leonardosilva-leic/ProjetoLIC-ISEL/Relatorios/finalReportTicketMachine.pdf

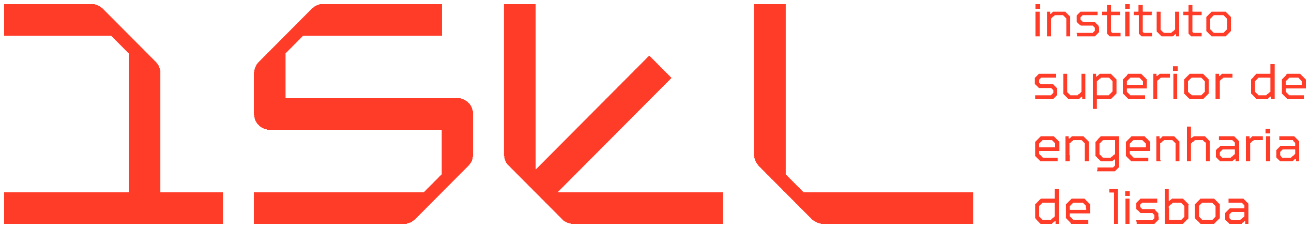
[picture p1: figure]

## Licenciatura em Engenharia Informática e de Computadores

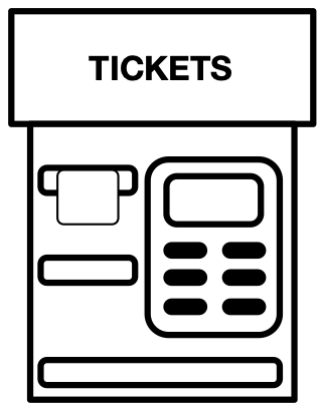
[picture p2: figure]

## MÁQUINA DE VENDA DE BILHETES

# (Ticket Machine)

Projeto
de
Laboratório de Informática e Computadores 2025 / 2026 verão

Trabalho Realizado por:
54035: Beatriz Leme 53799: Leonardo Silva 53652: Miguel Ruivo

Docentes: David Velez, Nuno Sebastião, Pedro Miguens, Rogério Rebelo, Rui

Duarte

12 de junho de 2026

2

## Conteúdo

1 Descrição | 1
2 Arquitetura do Sistema | 3
3 Resultados Experimentais | 18
4 Conclusões | 21
5 Trabalho Futuro | 21
Referências | 23
A Ticket Machine - Hardware | 24

i

B Ticket Machine - Software (Control) | 27

ii

## Lista de Figuras

1 | Diagrama de blocos da Máquina de Venda de Bilhetes (Ticket Machine) | | 1
2 | Arquitetura do sistema que implementa a máquina de venda de bilhetes (Ticket
Machine) | | 3
3 | Diagrama de blocos do Keyboard Reader | | 4
4 | Diagrama de blocos | | 4
5 | Bloco Key Decode - Diagrama temporal | | 5
6 | Diagrama temporal | | 6
7 | Diagrama de blocos | | 7
8 | Diagrama de blocos | | 8
9 | Diagrama de blocos | | 10
10 | Composição do Datapath | | 11
11 | Bloco Coin Acceptor | | 11
a | Diagrama de blocos | | 11
b | Diagrama temporal | | 11
12 | Diagrama de blocos do módulo Port Expander LCD (PELCD) | | 12
13 | Protocolo de comunicação com o módulo Port Expander LCD (PELCD) | | 12
14 | Diagrama de blocos do módulo Port Expander Ticket Dispenser (PETD) . . . . | 13
15 | Protocolo de comunicação com o Port Expander Ticket Dispenser (PETD) . . . | 13
16 | Protocolo de comunicação com o mecanismo de dispensa de bilhetes (Ticket Dis-
penser ) | | 14
17 | Diagrama de blocos do bloco Serial Receiver | | 14
18 | Diagrama lógico da Máquina de Venda de Bilhetes (Ticket Machine) | | 15
19 | Simulação do preenchimento da memória RAM do Ring Buffer e ativação dos
sinais empty e full | | 18
20 | Ativação e apresentação do menu do modo de Manutenção no simulador de hardware. 20

## Lista de Tabelas

1 | Codificação do valor facial das moedas | | 12
2 | Atribuição de pinos para a função F [4] | | 26

## Lista de Algoritmos

1 | TicketMachineAPP | | 27
2 | M | | 35
3 | TUI | | 36
4 | Coin Acceptor | | 40
5 | Coin Deposit | | 41
6 | File Access | | 42

iii

Laboratório de Informática e Computadores 2025/2026 verão Máquina de Venda de Bilhetes (Ticket Machine)

## 1 Descrição

Este projeto implementa uma máquina de venda de bilhetes (Ticket Machine), que permite a aquisição de bilhetes de comboio. O percurso é definido pela estação de origem, local de compra do bilhete e pela seleção do destino digitando o identificador da estação ou através das teclas ↑ e ↓, sendo exibido no ecrã além do identificador da estação de destino o preço e o tipo de bilhete (ida ou ida/volta). A ordem de aquisição é dada através da pressão da tecla de confirmação, sendo impressa uma unidade do bilhete exibido no ecrã. A máquina não realiza trocos e só aceita moedas de: 0,05e; 0,10e; 0,20e; 0,50e; 1,00e; e 2,00e. Para além do modo de Dispensa, o

sistema tem mais um modo de funcionamento designado por Manutenção, que é ativado por uma chave de manutenção. Este modo permite o teste da máquina de venda de bilhetes, bem como permite iniciar e consultar os contadores de bilhetes e moedas. A máquina de venda de bilhetes é constituída pelo sistema de gestão (designado por Control na Figura 1) e pelos seguintes periféricos: um teclado de 16 teclas, um moedeiro (designado por Coin Acceptor ), um ecrã Liquid Cristal Display (LCD) de duas linhas de 16 caracteres, um mecanismo de dispensa de bilhetes (designado por Ticket Dispenser ) e uma chave de manutenção (designada por M ) que define se a máquina de venda de bilhetes está em modo de Manutenção, conforme o diagrama de blocos apresentado na Figura 1.

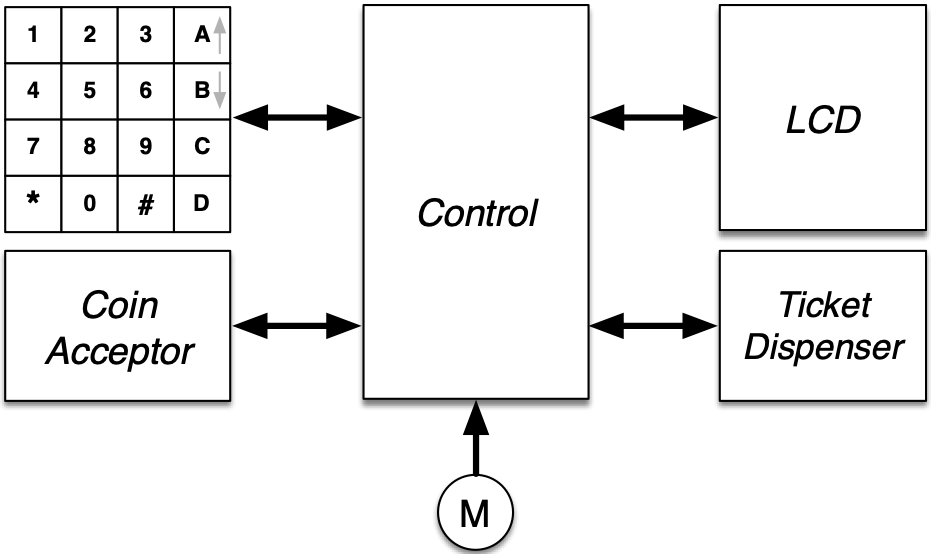
[picture p3: figure]

Figura 1: Diagrama de blocos da Máquina de Venda de Bilhetes (Ticket Machine)

Sobre o sistema podem-se realizar as seguintes ações em modo Venda:

- Consulta e venda A consulta de um bilhete é realizada digitando o identificador da estação de destino ou listando-a através das teclas ↑ e ↓. O processo de compra do bilhete inicia-se premindo a tecla ‘#’. Durante a inserção do respetivo valor monetário, é possível alterar o tipo de bilhete (ida ou ida/volta) premindo a tecla ‘∗’, com a consequente alteração do preço da viagem afixado no LCD, duplicando o valor no caso de ida/volta. Durante a compra ficam afixados no LCD as informações referentes ao bilhete pretendido até que o mecanismo de impressão de bilhetes confirme que a impressão já foi realizada e a recolha do bilhete efetuada. A compra pode ser cancelada premindo a tecla ‘#’, devolvendo as moedas inseridas.

1

Sobre o sistema podem-se realizar as seguintes ações em modo Manutenção:

- Teste – Esta opção do menu permite realizar um procedimento de consulta e venda de um bilhete, sem introdução de moedas e sem esta operação ser contabilizada como uma aquisição.
- Consulta Bilhetes – Premindo a tecla ’A’, em seguida através das teclas ↑ e ↓, visualizam os contadores do número de bilhetes vendidos.
- Consulta Moedas – Premindo a tecla ’B’, em seguida através das teclas ↑ e ↓, visualizam os contadores das moedas no cofre.
- Iniciar os contadores de moedas e bilhetes – Premindo a tecla ’C’ e em seguida a tecla ’∗’, o sistema de gestão coloca os contadores de moedas e bilhetes a zero, iniciando um novo ciclo de contagem.
- Desligar – Premindo a tecla ’D’ permite desligar o sistema, que encerra apenas após a confirmação do utilizador, ou seja, o programa termina e as estruturas de dados, contendo a informação dos contadores de moedas e da lista de bilhetes vendidos, são armazenadas de forma persistente em dois ficheiros de texto. A informação em cada ficheiros deve estar organizada por linha, em que os campos de dados são separados por “;”, com o respetivo formato: ’COIN_V ALUE; NUMBER_COINS’ (valor facial; número de moedas) e ’P RICE; SOLD_T ICKET S; ST AT ION_NAME’ (preço; número de bilhetes vendidos para a estação; nome da estação). Os dois ficheiros devem ser carregados para o sistema no seu processo de arranque.

Nota: A inserção de informação através do teclado tem o seguinte critério: i) se não for premida nenhuma tecla num intervalo de cinco segundos o comando em curso é abortado; ii) quando o dado a introduzir é composto por mais que um dígito, são considerados apenas os últimos dígitos, a inserção realiza-se do dígito de maior peso para o de menor peso.

2

## 2 Arquitetura do Sistema

O sistema implementa uma solução híbrida de hardware e software, como apresentado no diagrama de blocos da Figura 2. A arquitetura proposta é constituída por cinco módulos principais:
i) um leitor de teclado, designado por Keyboard Reader ; ii) um módulo de interface com o LCD, designado por Port Expander LCD (PELCD); iii) um módulo de interface com o mecanismo de dispensa de bilhetes (Ticket Dispenser ), designado por Port Expander Ticket Dispenser (PETD); iv) um moedeiro, designado por Coin Acceptor ; e v) um módulo de controlo, designado por Control.
Os módulos i), ii) e iii) deverão ser implementados em hardware, o moedeiro (iv) será emu-lado utilizando quatro interruptores e três LED, enquanto o módulo de controlo (v) deverá ser implementado em software, descrito em linguagem Kotlin e executado num PC.

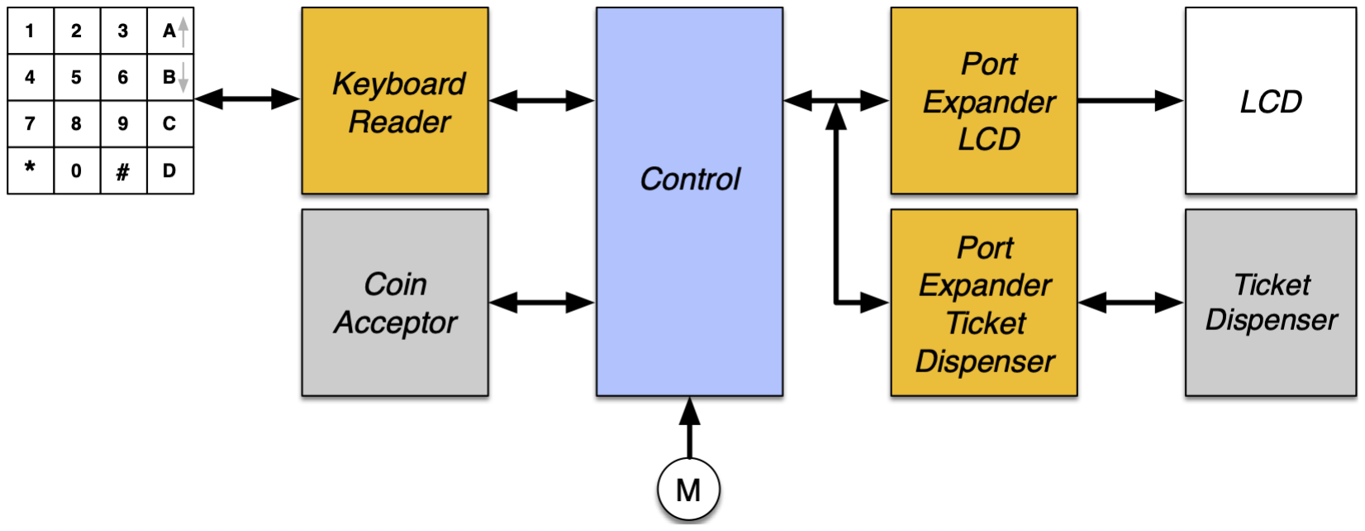
[picture p4: figure]

Figura 2: Arquitetura do sistema que implementa a máquina de venda de bilhetes (Ticket Machine)

O módulo Keyboard Reader é responsável pela descodificação do teclado matricial de 16 teclas, determinando qual a tecla pressionada e disponibilizando o seu código, com quatro bits, ao módulo Control. Caso este não esteja disponível para o receber imediatamente, o código da tecla é armazenado internamente, até ao limite de dezoito (18) códigos. O módulo Control processa os dados e envia a informação a apresentar no LCD através do módulo PELCD. O Ticket Dispenser é atuado pelo módulo Control, através do módulo PETD. Por forma a minimizar o número de interligações, a comunicação entre o módulo Control e os módulos PELCD e PETD é realizada através de um protocolo série.

### 2.1 Keyboard Reader

O módulo Keyboard Reader [1] é constituído por três blocos principais: i) o descodificador de teclado (Key Decode); ii) o bloco de armazenamento (designado por Ring Buffer ); e iii) o bloco de entrega ao consumidor (designado por Key Transmitter ). Neste caso o módulo Control, implementado em software, é a entidade consumidora.

3

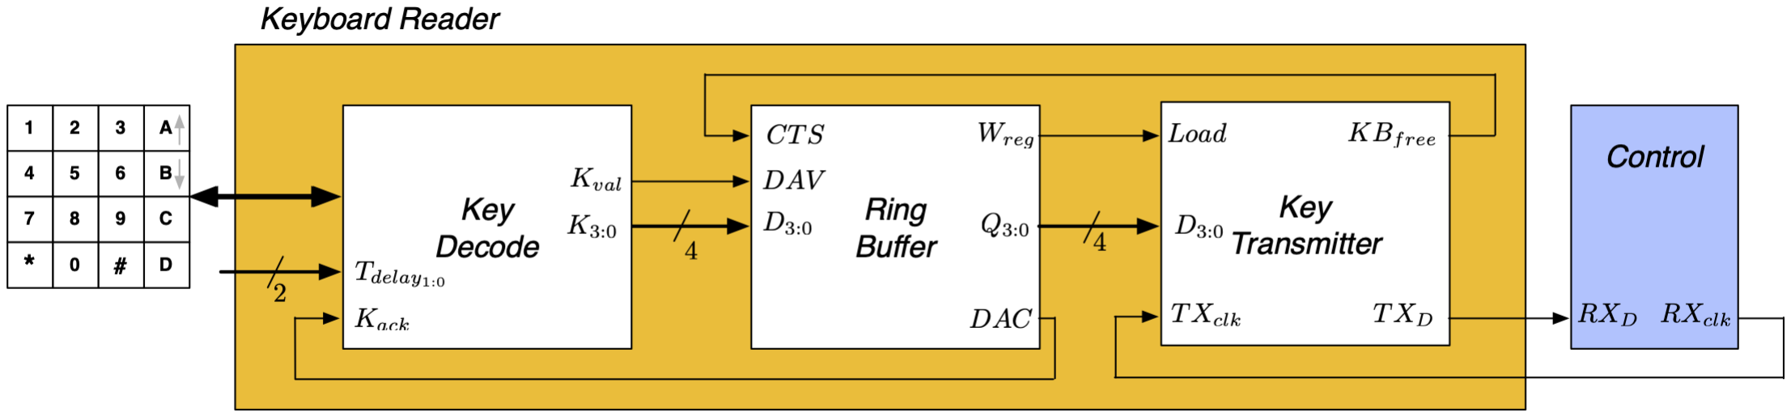
[picture p5: figure]

Figura 3: Diagrama de blocos do Keyboard Reader

### 2.1.1 KeyDecode

O bloco Key Decode tem como principal função implementar um descodificador em hardware para um teclado matricial de 4 × 4. Estruturalmente, este sistema divide-se em três sub-blocos essenciais:

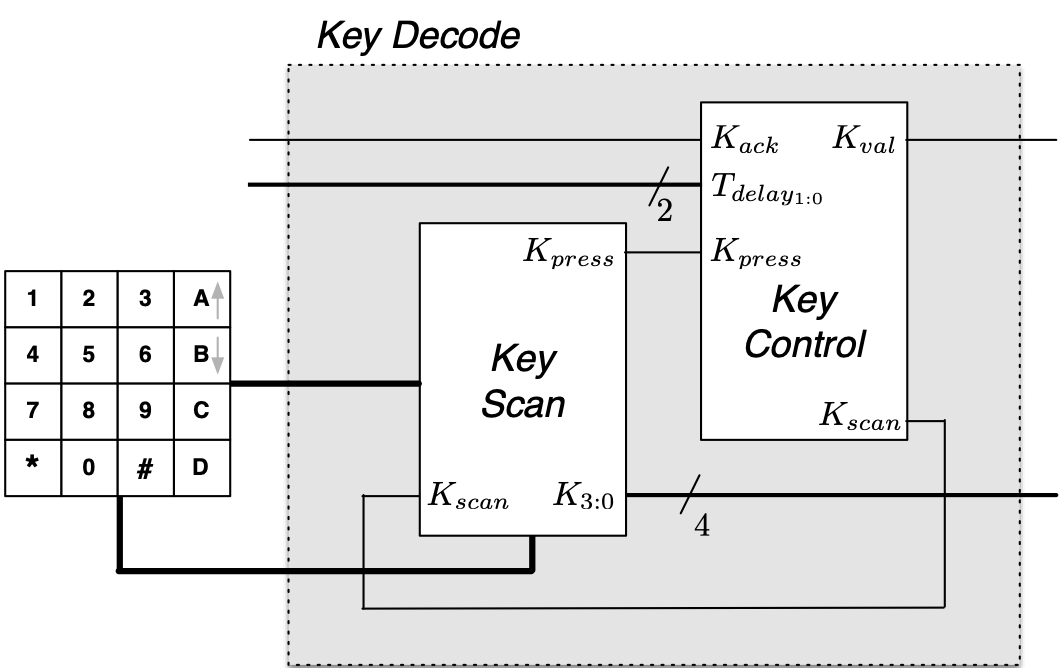
[picture p6: figure]

Figura 4: Diagrama de blocos

Teclado matricial: A interface física de 4 × 4.

Key Scan: O módulo responsável por efetuar o varrimento contínuo das teclas, percorrendo as colunas á procura de uma linha que tenha sido ativada ao premir o botão do teclado.

Key Control: A unidade lógica que realiza o controlo do varrimento e gere o fluxo de dados do sistema que controla o Tdelay e segue o ASM presente na Figura 5.

4

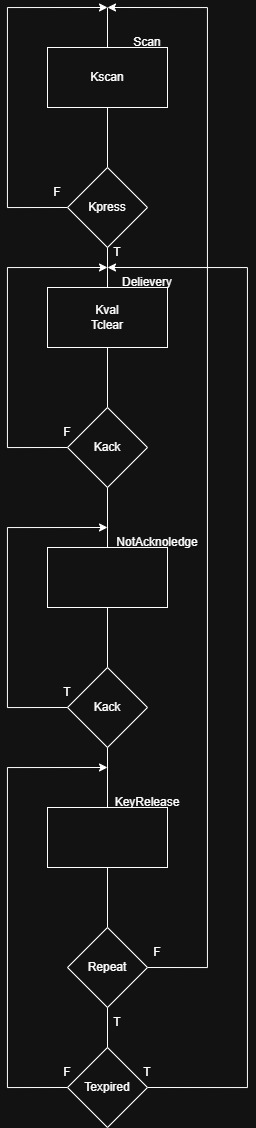
[picture p7: figure]

Figura 5: Bloco Key Decode - Diagrama temporal

5

Sempre que o sistema deteta a pressão de uma tecla, o sinal de saída Kval é ativado. Simultane-amente, o código representativo dessa tecla é disponibilizado no barramento de dados K3:0.

Numa fase inicial, um novo ciclo de varrimento apenas se inicia após a tecla ser libertada e mediante a receção do sinal de reconhecimento Kack.

Numa segunda fase do projeto, o sistema incorpora um mecanismo de repetição de tecla (auto repeat). Caso a tecla se mantenha pressionada, o sistema gera automaticamente um novo código após um período de tempo pré-determinado, definido pela variável de entrada Tdelay1:0 . Os períodos de atraso configuráveis são os seguintes:

- 00: 500 ms
- 01: 1000 ms
- 10: 1500 ms
- 11: 2000 ms

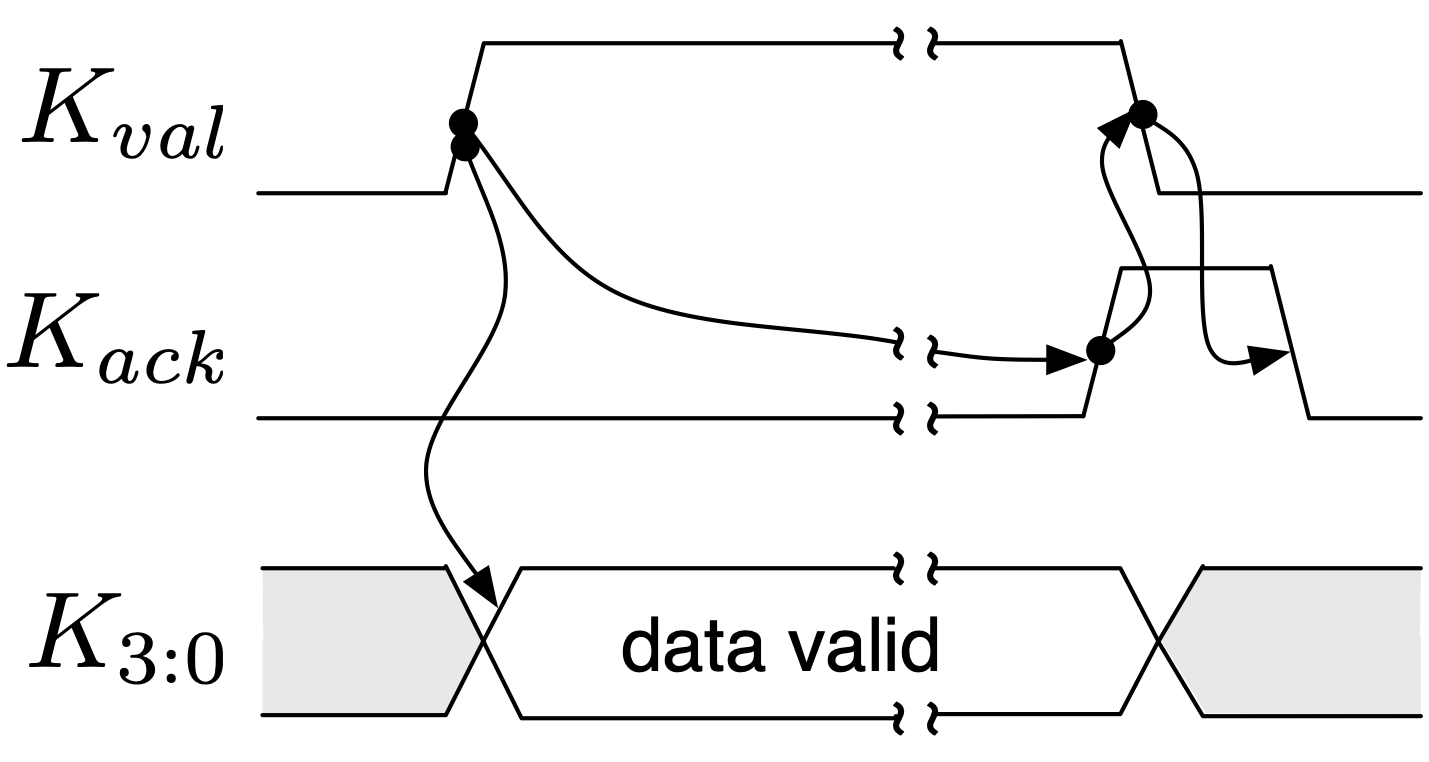
[picture p8: figure]

Figura 6: Diagrama temporal

Para a realização do varrimento do teclado, foi adotada a Versão I da arquitetura do bloco Key Scan.Nesta configuração, o circuito é conduzido por um oscilador que alimenta o sinal de clock de um contador síncrono. As saídas deste contador são divididas para controlar dois componentes em paralelo:

6

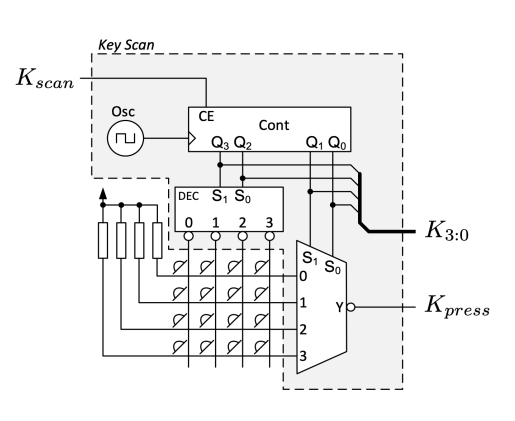
[picture p9: figure]

Figura 7: Diagrama de blocos

Descodificador (Decoder): Recebe parte dos bits do contador para ativar sequencialmente as linhas do teclado matricial.

Multiplexer (MUX): Utiliza os restantes bits do contador como sinais de seleção para ler o estado das colunas do teclado, canalizando o resultado para a saída Kpress.

Esta abordagem garante um varrimento cíclico e sincronizado, permitindo que o bloco Key Control identifique de forma precisa as coordenadas da tecla acionada.

### 2.1.2 RingBuffer

O bloco Ring Buffer implementa uma estrutura de dados para armazenamento de teclas com disciplina FIFO, com capacidade de armazenar até dezasseis (16) palavras de quatro (4) bits. E é composto por 3 sub-blocos: O Memory Adress Control (MAC) que tem como objetivo indicar o endereço respetivo à operação realizada de acordo com a entrada de seleção PnG do bloco, o RingBufferControl que é a maquina de estados que vai controlara o RingBuffer tendo em conta os sinais que vai receber provenientes do KeyDecode (DAV) e do KeyTransmitter(CTS) e por fim a RAM que vai armazenar as 16 palavaras de 4 bits.

7

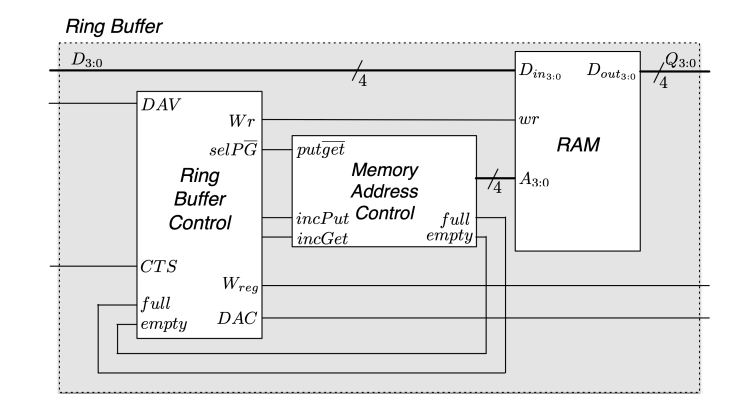
[picture p10: figure]

Figura 8: Diagrama de blocos

### 2.1.3 RingBufferControl

A coordenação do fluxo de dados e da interação com os módulos adjacentes é realizada pelo bloco Ring Buffer Control, cujo comportamento é ditado pela máquina de estados implementada. A partir do seu estado inicial (Idle), o sistema ramifica a sua execução consoante se trate de um processo de escrita ou de leitura:
1. Processo de Escrita (Interação com o Sistema Produtor):
- A escrita é desencadeada quando o sistema produtor (neste caso, o Key Decode) ativa o sinal DAV (Data Available).
- Se a memória não estiver cheia (condição Full falsa), a máquina transita para o estado prev_Write, ativando o sinal PnG para selecionar o endereço putIndex no MAC.
- No estado seguinte, Writing, o sistema ativa o sinal de escrita Wr mantendo o PnG ativo, o que efetiva o registo dos dados D3:0 na RAM.
- Imediatamente a seguir, no estado pos_write, é emitido o comando incput (em conjunto com o PnG) para atualizar o endereço de escrita.
- Concluída esta etapa, a máquina entra no estado ack_Producer, ativando o sinal DAC (Data Accepted). Esta ação serve para informar o sistema produtor de que os dados foram guardados com sucesso.
- O sistema produtor deve então desativar o DAV; só após essa desativação é que a máquina de estados abandona o estado ack_Producer, regressando a Idle e desativando consequen-temente o DAC.
2. Processo de Leitura (Interação com a Entidade Consumidora):
- A leitura de dados ocorre sempre que a entidade consumidora indica disponibilidade para receber informação, através da ativação do sinal CTS (Clear To Send).
- A partir do estado Idle, caso não haja solicitações pendentes de escrita (ou se houver uma solicitação de escrita mas a RAM estiver cheia), a máquina verifica o estado do sinal CTS.

8

- Se o CTS estiver ativo e houver dados disponíveis na memória (condição Empty falsa), a máquina avança para o estado Reading. Neste estado, é gerado o sinal Wreg.
- O sistema aguarda no estado Reading até que o sinal CTS seja desativado pela entidade consumidora.
- Após a transição descendente de CTS, a máquina passa para o estado pos_Read, onde emite o sinal incget para incrementar o endereço de leitura no MAC. Finalmente, retorna ao estado Idle, concluindo o ciclo.

9

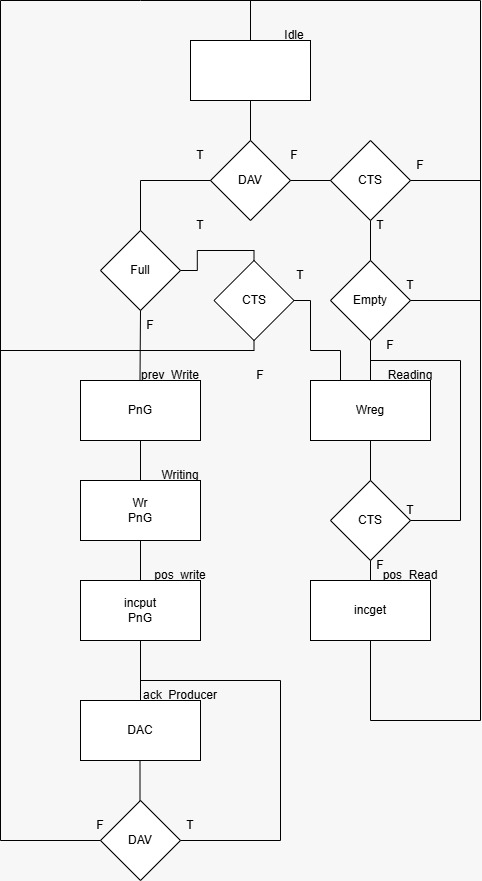
[picture p11: figure]

Figura 9: Diagrama de blocos

### 2.1.4 KeyTransmiter

O bloco Key Transmitter é responsavel por atuar como uma interface de comunicação série entre o módulo produtor (responsável por registar fisicamente a tecla pressionada) e o módulo consumidor (o módulo Control central do sistema). O mesmo é composto por 2 sub-blocos

10 muito importantes: o Datapath que contem os componentes físicos necessários para armazenar e encaminhar os bits corretos para a saída série(a sua composição está presente na Figura 10) e o Controlo que é o que vai controlar o Datapath seguindo o ASM presente na Figura 10.

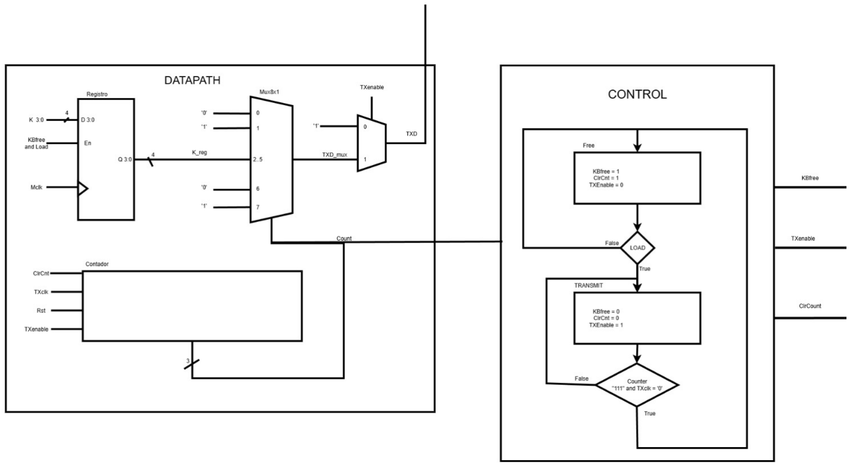
[picture p12: figure]

Figura 10: Composição do Datapath

### 2.2 Coin Acceptor

O módulo Coin Acceptor implementa a interface com o moedeiro, sinalizando ao módulo Control que o moedeiro recebeu uma moeda através da ativação do sinal Coin, o valor monetário da moeda inserida é codificado em Coinid2:0 , conforme a codificação apresentada na Tabela 1. A entidade consumidora informa o Coin Acceptor que já contabilizou a moeda ativando o sinal accept, conforme apresentado no diagrama temporal da Figura 11b. O Control pode devolver as moedas inseridas no moedeiro através da ativação do sinal eject durante dois segundos, ou reco-lher as moedas presentes no moedeiro através da ativação do sinal collect durante dois segundos.

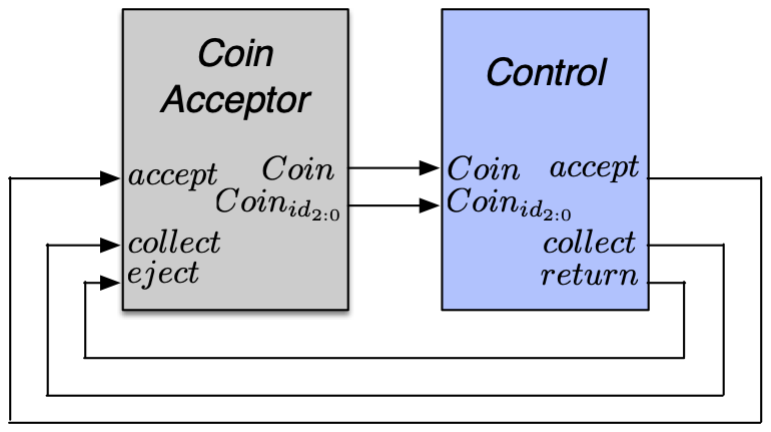
[picture p13: figure]

(a) Diagrama de blocos | (b) Diagrama temporal

Figura 11: Bloco Coin Acceptor

11

Tabela 1: Codificação do valor facial das moedas

Moeda [e] | Codificação [Cid2Cid1Cid0]
0,05 | 000
0,10 | 001
0,20 | 010
0,50 | 011
1,00 | 100
2,00 | 101

### 2.3 Port Expander LCD

O módulo Port Expander LCD [2] (PELCD) implementa a interface com o LCD, fazendo a receção em série da informação enviada pelo módulo de controlo e entregando-a posteriormente ao LCD, conforme representado na Figura 12.

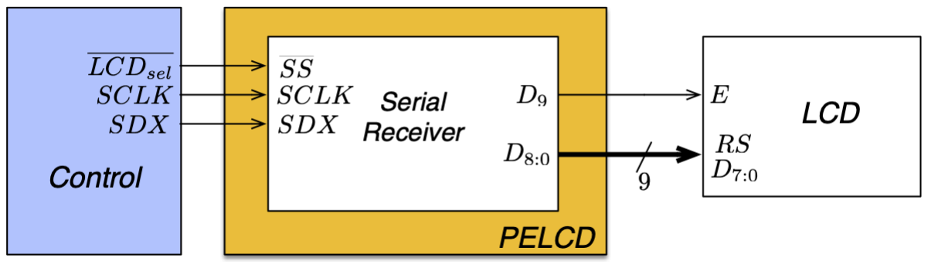
[picture p14: figure]

Figura 12: Diagrama de blocos do módulo Port Expander LCD (PELCD)

O módulo PELCD recebe em série uma mensagem constituída por dez (10) bits de informação. A comunicação com este módulo realiza-se segundo o protocolo ilustrado na Figura 13, em que o bit RS é o primeiro bit de informação e indica se a mensagem é de controlo ou dados. Os seguintes oito (8) bits contêm os dados a entregar ao LCD. O último bit contém o sinal de E responsável por registar a informação no LCD.

Figura 13: Protocolo de comunicação com o módulo Port Expander LCD (PELCD)

O emissor, realizado em software, quando pretende enviar uma trama para o módulo PELCD promove uma condição de início de trama (Start), que corresponde a uma transição descendente na linha (LCDsel). Após a condição de início, o módulo PELCD armazena os bits de dados da trama nas transições ascendentes do sinal SCLK. O bloco Serial Receiver do módulo PELCD é constituído por dois blocos principais: i) um registo de deslocamento; e ii) um registo de manutenção; designados por Shift Register e Hold Register respetivamente. O bloco Serial Receiver

12 deverá ser implementado com base no diagrama de blocos apresentado na Figura 17.

### 2.4 Port Expander Ticket Dispenser

O módulo Port Expander Ticket Dispenser [3] (PETD) implementa a interface com o mecanismo de impressão de bilhetes (Ticket Dispenser ), realizando a receção em série da informação enviada pelo módulo de controlo e entregando-a posteriormente ao mecanismo, conforme representado na Figura 14.

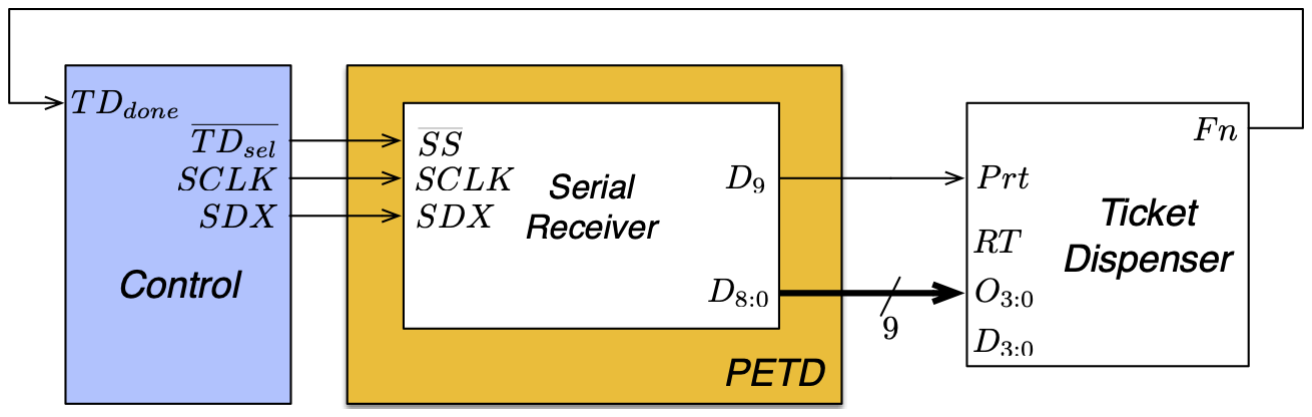
[picture p15: figure]

Figura 14: Diagrama de blocos do módulo Port Expander Ticket Dispenser (PETD)

O módulo PETD recebe em série uma mensagem composta por dez (10) bits de informação, segundo o protocolo de comunicação ilustrado na Figura 15. O primeiro bit de informação indica se o bilhete a imprimir é de ida ou ida/volta. Os quatro bits seguintes indicam a estação de origem, seguido da estação de destino por mais 4 bits de informação. O último bit de informação indica o início da impressão e disponibilização do bilhete. Só pode ser iniciada nova impressão quando o mecanismo de dispensa de bilhetes informar o Control que o processo terminou através do sinal Fn.

Figura 15: Protocolo de comunicação com o Port Expander Ticket Dispenser (PETD)

O Ticket Dispenser recebe em 4 bits o código da estação de destino (D3:0), noutros 4 bits o código da estação de origem (O3:0) a imprimir no bilhete e ainda o bit RT que define o tipo de bilhete (ida ou ida/volta). O comando de impressão do bilhete com os códigos presentes em D, O e RT é realizado pela ativação do sinal de impressão (P rt). Em resposta, o Ticket Dispenser ativa o sinal de término de execução (F n) quando concluída a dispensa do bilhete. Os sinais F n e P rt têm o comportamento descrito no diagrama temporal apresentado na Figura 16.

13

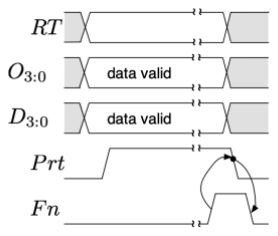
[picture p16: figure]

Figura 16: Protocolo de comunicação com o mecanismo de dispensa de bilhetes (Ticket Dispenser )

### 2.4.1 SeriaReciver

Tanto o Port Expander LCD como Port Expander Ticket Dispenser utilizam o componete SerialReciver que é responsável por interpretar as tramas enviadas pelo sistema de controlo através de uma linha série.

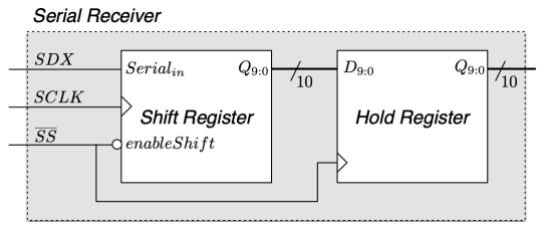
[picture p17: figure]

Figura 17: Diagrama de blocos do bloco Serial Receiver

### 2.5 Control

A implementação do módulo Control foi realizada em software, usando a linguagem Kotlin e seguindo a arquitetura lógica apresentada na Figura 18. O Controlo contem:

### 2.5.1 HAL

O HLA é o responavel por isolar a lógica aplicacional dos detalhes físicos do sistema, fornecendo uma interface simplificada para a manipulação dos portos de entrada e saída através do módulo UsbPort.

14

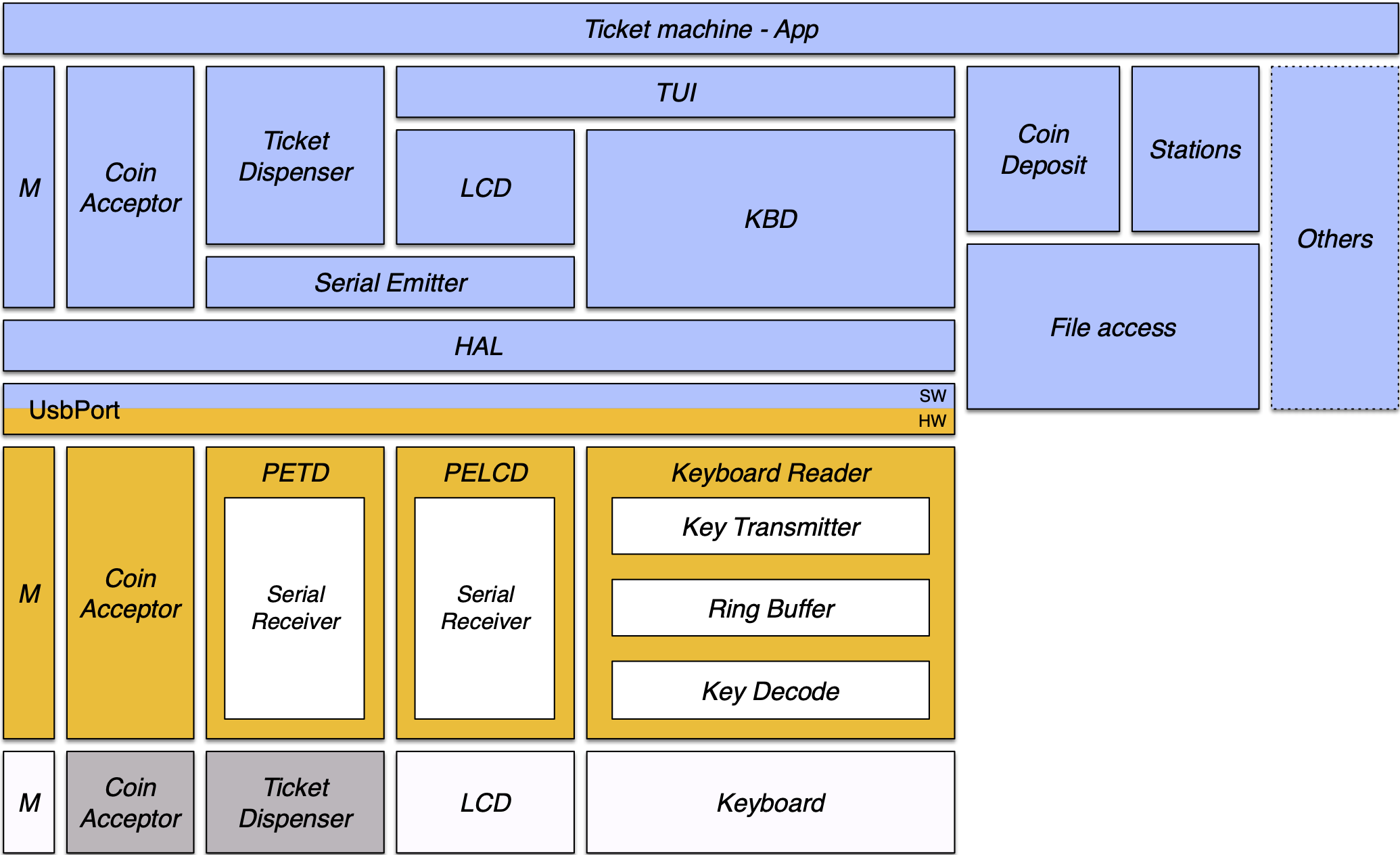
[picture p18: figure]

Figura 18: Diagrama lógico da Máquina de Venda de Bilhetes (Ticket Machine)

### 2.5.2 KBD

O módulo KBD a gere e leitura do teclado matricial, abstendo-se dos detalhes de comunicação física ao interagir com as camadas inferiores através dos módulos HAL e SerialReceiver. Na sua inicialização, o módulo assegura a correta configuração dos periféricos e do recetor de dados em série, preparando o sistema para a captura de eventos de pressão de teclas e está tambem encarregue da tradução dos sinais logicos para os caracteres defeniudos no mesmo.

### 2.5.3 TUI

O módulo TUI é o responsável por gerir tudo o que o utilizador vê no ecrã e as teclas que prime, servindo de ponte entre o ecrã (LCD) e o teclado (KBD). Na inicialização, este módulo prepara o ecrã e o teclado, controlando os menus da aplicação.

### 2.5.4 LCD

O módulo LCD é o responsável por controlar diretamente o ecrã de 2 linhas por 16 colunas. Ele serve para traduzir o texto e os comandos que o programa envia em sinais elétricos que o ecrã consegue processar, comunicando através do módulo SerialEmitter.

### 2.5.5 TD

O módulo TD (Ticket Dispenser) é o componente encarregue de controlar o hardware responsável pela impressão e emissão física dos bilhetes. Ele traduz as escolhas feitas pelo utilizador no programa em dados binários estruturados que são enviados para a impressora periférica através do módulo SerialEmitter.

15

### 2.5.6 SerialReciver

O módulo SerialReceiver é o responsável por receber dados enviados em série pelo hardware (neste caso, os códigos das teclas do teclado) e transformá-los em valores numéricos que o programa consegue usar. Ele funciona através do controlo manual de um sinal de relógio (clock) e da leitura de uma linha de dados (RXD).

### 2.5.7 SerialEmitter

O módulo SerialEmitter traduz comandos e dados do programa para um formato em série de forma a enviá-los para os periféricos. Partilha as mesmas linhas de dados (SDX) e de relógio (SCLK) que o SerialReciver, mas consegue escolher qual o componente que vai receber a informação através de linhas de seleção dedicadas.

### 2.5.8 CoinAcceptor

O módulo CoinAcceptor é o responsável por controlar o hardware do moedeiro da máquina. Ele interage diretamente com os pinos da HAL para detetar quando o utilizador insere moedas, identificar o seu valor em cêntimos e comandar os switchs que aceitam, devolvem ou guardam o dinheiro.

### 2.5.9 CoinDeposit

O ficheiro CoinDeposit define uma estrutura de dados simples (CoinEntry), que serve para gerir o inventário e a contabilidade do dinheiro dentro do sistema. Ao contrário dos módulos ante-riores, este componente não mexe diretamente no hardware, servindo apenas para organizar a informação em memória.

### 2.5.10 FileAccess

O módulo FileAccess é o modulo encarregue de garantir a persistência de dados do sistema, permitindo guardar e carregar informações diretamente em ficheiros de texto do computador. Desta forma, a máquina não perde o histórico de bilhetes vendidos nem o stock de moedas quando é desligada.

### 2.5.11 M

O módulo M é um componente muito simples que serve exclusivamente para detetar o estado do interruptor físico de manutenção da máquina. Este interruptor é o que define se a máquina está em modo de funcionamento normal ou em modo de manutenção.

### 2.5.12 Stations

O ficheiro Stations define uma estrutura de dados simples chamada Station, que serve para guardar na memória do programa todas as informações individuais sobre cada paragem disponível na máquina. Tal como o depósito de moedas.

16

### 2.5.13 TicketMachineAPP

O módulo TicketMachineApp controla o funcionamento global da máquina de bilhetes, ligando todos os módulos criados anteriormente (moedeiro, ecrã, teclado, ficheiros e impressora) e gerindo os passos que o utilizador tem de dar para comprar um bilhete.

17

## 3 Resultados Experimentais

### 3.1 Simulação Funcional do Hardware

Para verificar o correto funcionamento dos módulos implementados em VHDL, recorreu-se ao ModelSim para executar as respetivas simulações funcionais. Foram desenvolvidas testbenches para os diferentes componentes do sistema, permitindo estimular os sinais de entrada e observar os correspondentes sinais de saída e de controlo.
Durante as simulações foram analisados, entre outros aspetos, o funcionamento das máquinas de estados, os protocolos de comunicação entre os diferentes módulos, o armazenamento e a transmissão dos dados, a ativação dos sinais de validação e confirmação e a correta receção das tramas série.
Foram realizadas simulações individuais dos módulos Key Decode, Ring Buffer, Key Transmitter, Coin Acceptor, Port Expander LCD e Port Expander Ticket Dispenser, bem como testes de integração entre os blocos que constituem o sistema.
Como exemplo dos testes realizados, apresenta-se na Figura 19 a simulação do armazenamento de dados na memória RAM utilizada pelo Ring Buffer. Este módulo implementa uma estrutura de armazenamento com disciplina FIFO (First In, First Out), com capacidade para dezasseis palavras de quatro bits.
Durante o teste foram introduzidos sequencialmente os valores compreendidos entre 0000 e 1111. Na forma de onda é possível observar que cada valor é armazenado numa posição diferente da memória, preenchendo sucessivamente as dezasseis posições disponíveis.
Inicialmente, o sinal empty encontra-se ativo, indicando que o Ring Buffer não contém dados armazenados. Após a primeira operação de escrita, este sinal é desativado. À medida que são

introduzidos novos valores, as posições seguintes da memória são preenchidas até ser atingida a capacidade máxima da estrutura.
Após a escrita do décimo sexto elemento, o sinal full é ativado, indicando que não existem posições livres para o armazenamento de novos dados. Posteriormente, quando é realizada uma operação de leitura e uma posição volta a ficar disponível, o sinal full é desativado.
A simulação permitiu, assim, confirmar a correta escrita dos dados nas posições da memória RAM e o funcionamento dos sinais de estado empty e full, responsáveis por indicar, respetivamente, se o Ring Buffer se encontra vazio ou completamente preenchido.

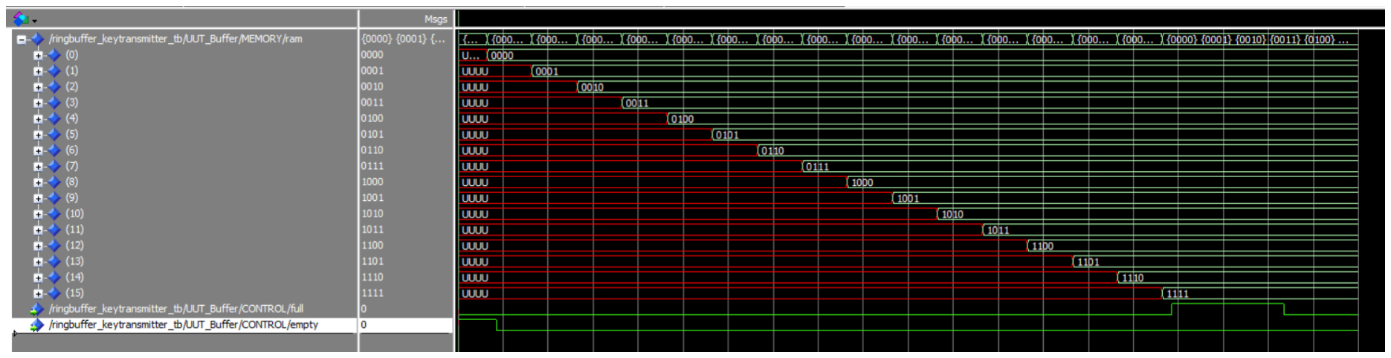
[picture p19: figure]

Figura 19: Simulação do preenchimento da memória RAM do Ring Buffer e ativação dos sinais empty e full.

18

### 3.2 Simulação do Software

Para validar o funcionamento da aplicação desenvolvida em Kotlin sem recorrer diretamente à placa FPGA, foi utilizado o simulador de hardware disponibilizado pelos docentes. Este ambiente permite emular os principais periféricos da Máquina de Venda de Bilhetes, nomeadamente o teclado matricial, o LCD, o Coin Acceptor, o Keyboard Transmitter, o Ring Buffer e o Ticket Dispenser.
A utilização do simulador permitiu testar a interação entre o módulo de controlo implementado em software e os diferentes componentes de hardware emulados. Foram verificadas as funcionalidades associadas ao modo de Venda e ao modo de Manutenção, incluindo a seleção de destinos, a aquisição e o cancelamento de bilhetes, a introdução de moedas e a consulta dos respetivos contadores.
Como exemplo dos testes realizados, apresenta-se na Figura 20 a ativação do modo de Manutenção. Este modo é selecionado através da chave de manutenção, representada pelo sinal M no simulador.
Após a ativação da chave, a aplicação abandona o funcionamento normal de venda e apre-senta no LCD o menu correspondente às operações de manutenção. Na situação representada, é apresentada a opção de consulta dos contadores de moedas, permitindo ao utilizador aceder às informações relativas às moedas armazenadas no sistema.
Através do teclado, é possível selecionar as diferentes funcionalidades do modo de Manutenção, nomeadamente o teste da máquina, a consulta dos contadores de bilhetes, a consulta dos contadores de moedas, a inicialização dos contadores e o encerramento da aplicação.
A simulação permitiu confirmar a correta deteção da chave de manutenção, a alteração do modo de funcionamento da aplicação e a apresentação das respetivas opções no LCD.

19

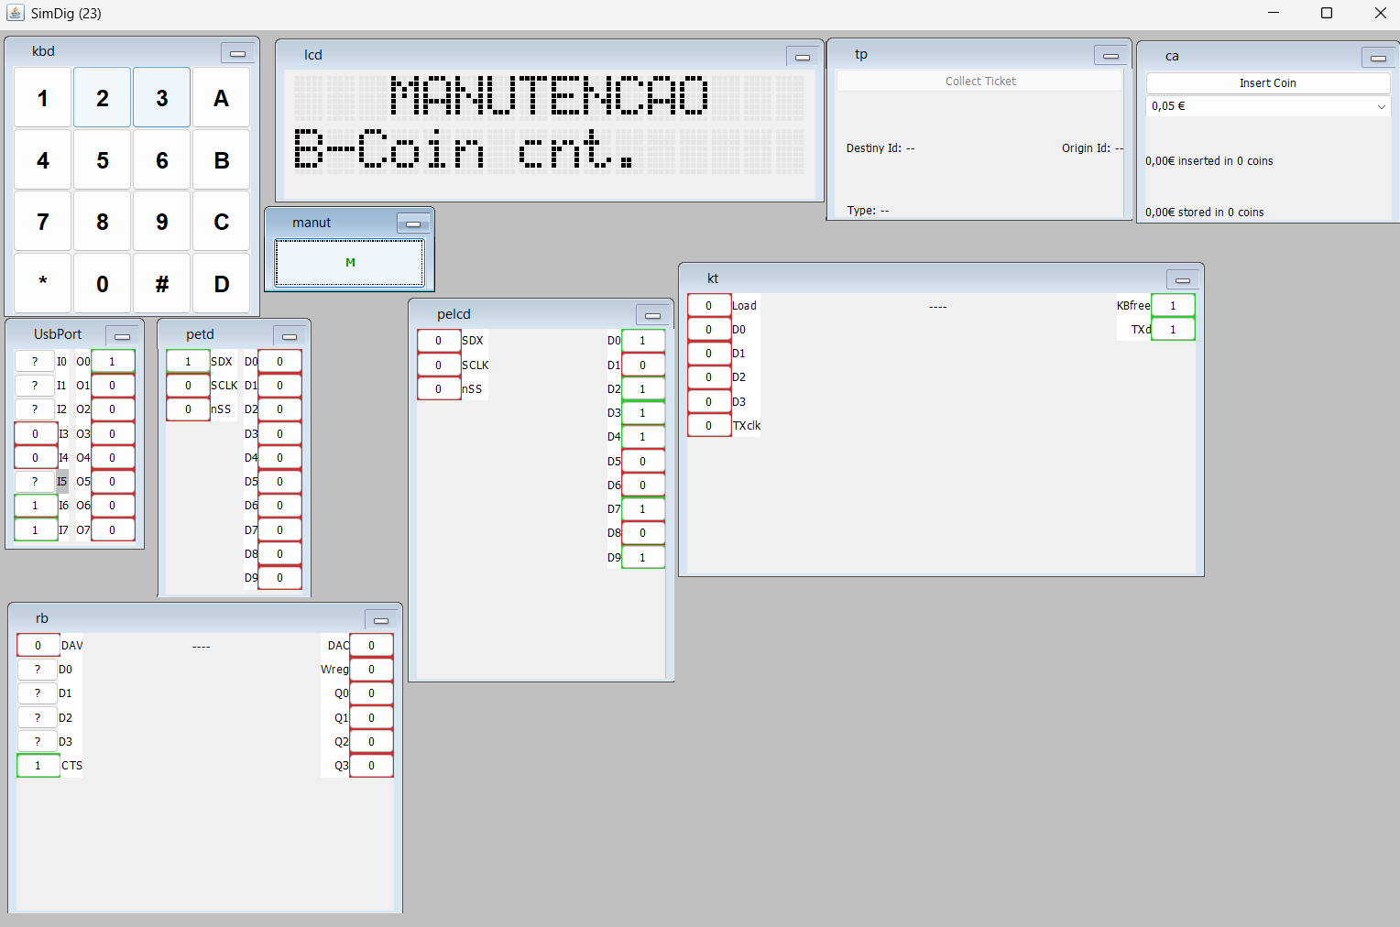
[picture p20: figure]

Figura 20: Ativação e apresentação do menu do modo de Manutenção no simulador de hardware.

20

## 4 Conclusões

O trabalho consistiu no desenvolvimento de uma máquina de venda de bilhetes chamada "Ticket Machine", conjugando componentes de hardware e software para garantir o funcionamento de todas as funções presentes na descrição do projeto. Para esse efeito, foi utilizada uma FPGA pro-gramada com a linguagem de descrição de hardware VHDL, a partir do ambiente Quartus Prime, e um computador com um software de controlo implementado em Kotlin. Os resultados experimentais confirmam o funcionamento do circuito de acordo com a descrição do funcionamento apresentada no enunciado.
Estes resultados foram obtidos a partir de testes realizados a cada componente, utilizando o ModelSim, uma extensão do programa Quartus que permite testar os componentes a partir dos ficheiros testbench que criámos, onde simulámos sinais e valores de entrada para observar os valores de saída e, assim, verificar o bom funcionamento de cada bloco que constitui o hardware do sistema.
Para realizar testes ao software em Kotlin, foi utilizado o ficheiro de simulação fornecido pelos docentes, que permite simular o software individualmente, para depois ser conectado ao hardware e testar o conjunto na placa de desenvolvimento FPGA DE10-Lite.
Os testes em hardware do sistema completo permitiram verificar o funcionamento total do sistema e também a realização de pequenos ajustes para o melhor funcionamento da máquina de venda de bilhetes implementada pelo grupo.

## 5 Trabalho Futuro

O trabalho pode ser melhorado em diversos aspetos, tanto ao nível do hardware como do software. No lado do hardware, uma possível otimização seria a remoção da estrutura de dados com disciplina FIFO (Ring Buffer) presente no módulo Keyboard Reader, uma vez que, no contexto atual do projeto, o sistema de controlo consome os dados praticamente ao mesmo ritmo a que são produzidos. Isto torna os buffers, na prática, dispensáveis, permitindo reduzir a complexidade do circuito e o consumo de recursos na FPGA.
Uma melhoria significativa do ponto de vista da experiência do utilizador seria a implementação de um menu deslizante ("scrollable") no ecrã LCD, permitindo o deslocamento horizontal e vertical entre as opções de estações através das teclas do teclado. Esta funcionalidade é es-pecialmente útil quando o número de opções excede a capacidade de visualização simultânea do display, tornando a navegação mais intuitiva e eficiente. O sistema manteria internamente o controlo da posição atual do cursor (linha e coluna), atualizando dinamicamente o conteúdo do LCD conforme o utilizador se desloca. Adicionalmente, poderiam ser apresentados indicadores visuais, como setas, para sinalizar a existência de mais opções além das atualmente visíveis. Outra melhoria fundamental seria a implementação de um sistema de devolução de trocos. Atualmente, a especificação da máquina de venda de bilhetes dita que o sistema não realiza trocos. Expandir a máquina de estados do módulo Coin Acceptor e a lógica do sistema de gestão em software (Kotlin) para calcular a diferença monetária e acionar a dispensa das respetivas moedas de troco aumentaria significativamente o realismo e a complexidade do projeto.
Por fim, ao nível do software, a adição de um sistema multilíngue no módulo TUI permitiria que

21 a interface suportasse vários idiomas além do português. Tratando-se de uma máquina de venda de bilhetes de comboio, acomodar utilizadores estrangeiros (com opções como Inglês e Espanhol) seria uma adição de grande valor prático à aplicação final.

22

## Referências

[1] David Velez, Nuno Sebastião, Pedro Miguens Matutino, Rogério Rebelo, Rui Duarte KeyBoardReader datasheet, 2026, ISEL.
[2] David Velez, Nuno Sebastião, Pedro Miguens Matutino, Rogério Rebelo, Rui Duarte Port Expander LCD datasheet, 2026, ISEL.
[3] David Velez, Nuno Sebastião, Pedro Miguens Matutino, Rogério Rebelo, Rui Duarte Port Expander Ticket Dispenser datasheet, 2026, ISEL.
[4] Terasic DE10-lite User Manual, 2020, Terasic.
[5] Terasic de10-Lite Exp. Board - Reference Manual, 2022, Pedro Miguens Matutino

23

## A Ticket Machine - Hardware

A.1 TicketMachine.vhd

library ieee;
use ieee.std_logic_1164.all;

entity TicketMachine is
port(
MClk | : in std_logic;
Rst | : in std_logic;
Tdelay | : in std_logic_vector(1 downto 0);
linhas_in | : in std_logic_vector(3 downto 0);
CollectTicket: in std_logic;
Ca_Coin | | | : in std_logic;
Ca_CoinID | | | : in std_logic_vector(2 downto 0);
M | | | : in std_logic;
D | : out std_logic_vector(9 downto 0);
colunas_out | : out std_logic_vector(3 downto 0);
Ca_Collect | | | : out std_logic;
Ca_Accept | | | : out std_logic;
Ca_Eject | | | : out std_logic;
K | | | : out std_logic_vector(3 downto 0);
HEX0, HEX1, HEX2, HEX3, HEX4, HEX5: out STD_LOGIC_VECTOR(7 downto 0) );

end TicketMachine;

architecture structural of TicketMachine is

component KeyboardReader is
port(
MClk | : in std_logic;
Rst | : in std_logic;
Tdelay | : in std_logic_vector(1 downto 0);
linhas_in | : in std_logic_vector(3 downto 0);
Txclk | : in std_logic;
K | | | : out std_logic_vector(3 downto 0);
colunas_out : out std_logic_vector(3 downto 0);
TxD | : out std_logic
);

end component;

component UsbPort is
port(
inputPort | : | IN | STD_LOGIC_VECTOR(7 DOWNTO 0);
outputPort : | OUT | STD_LOGIC_VECTOR(7 DOWNTO 0)
);

end component;

component PELCD is
port(
SS : in std_logic;
SCLK : in std_logic;
SDX | : in std_logic;
Rst | : in std_logic;
D | : out std_logic_vector(9 downto 0)
);

end component;

component PETD is
port(
SS : in std_logic;
SCLK : in std_logic;
SDX | : in std_logic;
Rst | : in std_logic;
RT | : out std_logic;
Prt | : out std_logic;
O | : out std_logic_vector(8 downto 5);
D | : out std_logic_vector(4 downto 1)
);

end component;

component TICKET_DISPENSER is port (
RT, Prt, CollectTicket: in STD_LOGIC;
O, D: in STD_LOGIC_VECTOR(3 downto 0);
Fn: out STD_LOGIC;
HEX0, HEX1, HEX2, HEX3, HEX4, HEX5: out STD_LOGIC_VECTOR(7 downto 0) );

end component;

24

signal UsbPort_in | : std_logic_vector(7 downto 0);
signal UsbPort_out | : std_logic_vector(7 downto 0);
signal RT_out | : std_logic;
signal Prt_out | : std_logic;
signal O_out | : std_logic_vector(3 downto 0);
signal D_out | : std_logic_vector(3 downto 0);
signal K_out | : std_logic_vector(3 downto 0);

begin

UsbPort_in(0) | <= Ca_CoinID(0) ;
UsbPort_in(1) | <= Ca_CoinID(1) ;
UsbPort_in(2) | <= Ca_CoinID(2) ;
UsbPort_in(3) | <= Ca_Coin ;
--UsbPort_in(4) | <= s_Kval ;
UsbPort_in(5) | <= '0' ;
UsbPort_in(6) | <= M ;
--UsbPort_in(7) | <= '0' ;
--UsbPort_out(0) <= s_Ka ; --UsbPort_out(1) <= '0' ;
--UsbPort_out(2) <= '0' ;
--UsbPort_out(3) <= '0' ;
--UsbPort_out(4) <= Ca_Accept ; --UsbPort_out(5) <= Ca_Eject ; --UsbPort_out(6) <= Ca_Collect ; --UsbPort_out(7) <= '0' ;

KeyboardReader_V: KeyboardReader port map(
MClk | => MClk,
K | => K_out,
Rst | => Rst,
Tdelay | => Tdelay,
linhas_in | => linhas_in,
Txclk | => UsbPort_out(7),
colunas_out => colunas_out,
TxD | => UsbPort_in(7)
);

UsbPort_V: UsbPort
port map(
inputPort => UsbPort_in,
outputPort => Usbport_out
);

PETD_V: PETD
port map(
SS => UsbPort_out(3),
SCLK => Usbport_out(1),
SDX | => UsbPort_out(0),
Rst | => Rst,
RT | => RT_out,
Prt | => Prt_out,
O | => O_out,
D | => D_out
);

PELCD_V: PELCD
port map(
SS => UsbPort_out(2),
SCLK => Usbport_out(1),
SDX | => UsbPort_out(0),
Rst | => Rst,
D | => D
);

TicketDispencer_V: TICKET_DISPENSER port map(
RT | => RT_out,
Prt | => Prt_out,
CollectTicket => CollectTicket,
Fn | => Usbport_in(4),
O | => O_out,
D | => D_out,
HEX0 | => HEX0,
HEX1 | => HEX1,
HEX2 | => HEX2,
HEX3 | => HEX3,
HEX4 | => HEX4,
HEX5 | => HEX5
);
Ca_Accept | <= UsbPort_out(4);
Ca_Eject | <= UsbPort_out(5);
Ca_Collect <= UsbPort_out(6); K <= K_out;

25

end structural;

A.2 | Atribuição de Pinos
Entradas | pino
MClk Rst M CollectTicket Tdelay[0] Tdelay[1] Ca_Coin Ca_CoinId[0] Ca_CoinId[1] Ca_CoinId[2] linhas_in[0] linhas_in[1] linhas_in[2] linhas_in[3] | P11 F15 D12 A14 C10 C11 C12 A12 B12 A13 W5 AA14 W12 AB12
Saídas | pino
colunas_out[0] colunas_out[1] colunas_out[2] colunas_out[3] Ca_Accept Ca_Eject Ca_Collect K[0] K[1] K[2] K[3] D[0] D[1] D[2] D[3] D[4] D[5] D[6] D[7] D[8] D[9] HEXs | AB11 AB10 AA9 AA8 D13 C13 E14 A8 A9 A10 B10 W8 AA15 W13 AB13 Y11 W11 AA10 Y8 Y7 V5 Vários (ex: C14, C18, etc.)

Tabela 2: Atribuição de pinos para a função F [4]

26

## B Ticket Machine - Software (Control)

B.1 Ticket Machine - App

Algoritmo 1: TicketMachineAPP

import j a v a . t im e . Loca lDateT ime

object T icketMach ineApp {

pr ivate enum c l a s s S t a t e { WELCOME,
CHOOSE_STATION,
PAYMENT,
PRINTING,
WAIT_TICKET_COLLECTION,
THANK_YOU
}

pr ivate var s t a t e = S t a t e .WELCOME pr ivate var roundTr ip = f a l s e
pr ivate var r em a i n i n g P r i c e = 0
pr ivate var paidAmount = 0

pr ivate var m a in t en an c eT i c k e t Ind e x = 0 pr ivate var ma int enan c eCo in Ind ex = 0

pr ivate var ma intenanceMenuIndex = 0
pr ivate var lastMa intenanceMenuChange = 0L

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

s t a t e = S t a t e .WELCOME run ( )
}

pr ivate fun run ( ) {
while ( true ) {
i f ( Ma intenance . i s A c t i v e ( ) ) { runMaintenanceMode ( )
}

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

Thread . s l e e p ( 1 0 )
}
}

pr ivate fun runWelcome ( ) {

27

var lastShownM inute = −1

while ( s t a t e == S t a t e .WELCOME) { i f ( Ma intenance . i s A c t i v e ( ) ) { return
}

va l now = Loca lDateT ime . now ( )

i f (now . m inute != lastShownM inute ) { TUI . showWelcome (now)
lastShownM inute = now . m inute
}

va l key = TUI . getKey ( )

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

Thread . s l e e p ( 2 0 ) }
}

pr ivate fun runCh o o s eS t a t i on ( ) { va l key = TUI . getKey ( )
i f ( key == KBD. none ) return

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

'B' −> {
S t a t i o n s . n ext ( )
d r awS t a t i onCh o i c e ( )
}

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

}

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

}
}
}

pr ivate fun runPayment ( ) { va l key = TUI . getKey ( )

i f ( key != KBD. none ) { when ( key ) {

28

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

drawPayment ( )
return
}

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

s t a t e = S t a t e .WELCOME return
}
}
}

va l c o i n = Co inA c c eptor . g e tCo inVa lu e ( )

i f ( c o i n != nu l l ) {
Co inA c c eptor . a c c ep tC o in ( )
wa itCo inRemova l ( )

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

drawPayment ( )

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

TUI . showT i ck etFor ( s t a t i o n . name ) Thread . s l e e p ( 2 0 0 0 )

TUI . sh owP r in t in g ( )

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

29

Co inA c c eptor . c o l l e c t C o i n s ( )

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

s t a t e = S t a t e .WAIT_TICKET_COLLECTION }

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

TUI . showT icketReady ( s t a t i o n . name )

while ( !TD. i s F i n i s h e d ( ) ) {
Thread . s l e e p ( 2 0 )
}

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

s t a t e = S t a t e .THANK_YOU
}

pr ivate fun runThankYou ( ) { TUI . showThankYou ( )
Thread . s l e e p ( 5 0 0 0 )

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

s t a t e = S t a t e .WELCOME
}

pr ivate fun runMaintenanceMode ( ) { ma intenanceMenuIndex = 0
lastMa intenanceMenuChange = 0L

updateMa intenanceMenu ( )

while ( Ma intenance . i s A c t i v e ( ) ) { updateMa intenanceMenu ( )

va l key = wa itMa intenanceKey ( 1 0 0 )

i f ( ! Ma intenance . i s A c t i v e ( ) ) { break
}

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

'#' −> {
runMa int enan c eT est ( ) r es etMa int enan c eM enu ( ) }

'A' −> {

30 m a in t en an c eT i c k e t Ind e x = 0 showT i ck e tCoun t e rs ( )
r es etMa int enan c eM enu ( )
}

'B' −> {
ma int enan c eCo in Ind ex = 0 showCo inCounters ( )
r es etMa int enan c eM enu ( )
}

'C' −> {
c o n f i rmR e s e tC o u n t e r s ( ) r es etMa int enan c eM enu ( ) }

'D' −> {
con f irmShutdown ( )
r es etMa int enan c eM enu ( ) }
}

Thread . s l e e p ( 2 0 ) }

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

TUI . showWelcome ( Loca lDateT ime . now ( ) ) }

pr ivate fun r es etMa int enan c eM enu ( ) {
ma intenanceMenuIndex = 0
lastMa intenanceMenuChange = 0L updateMa intenanceMenu ( )
}

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

drawMa int enan c eT estCho i c e ( )

while ( Ma intenance . i s A c t i v e ( ) ) {
va l key = wa itMa intenanceKey ( 5 0 0 0 )

i f ( ! Ma intenance . i s A c t i v e ( ) ) { return
}

when ( key ) {
KBD. none −> {
TUI . showMa intenanceAborted ( ) Thread . s l e e p ( 1 5 0 0 )
return
}

'A' −> {
S t a t i o n s . p r e v i o u s ( )
drawMa int enan c eT estCho i c e ( ) }

31

'B' −> {
S t a t i o n s . n ext ( )
drawMa int enan c eT estCho i c e ( ) }

' ∗ ' −> {
roundTr ip = ! roundTr ip
drawMa int enan c eT estCho i c e ( ) }

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

TUI . sh owP r in t in g ( )

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

TUI . showT icketReady ( s t a t i o n . name )

while ( Ma intenance . i s A c t i v e ( ) && !TD. i s F i n i s h e d ( ) ) { Thread . s l e e p ( 2 0 )
}

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

return
}
}
}
}

pr ivate fun updateMa intenanceMenu ( ) {
va l now = System . c u r r e n t T im eM i l l i s ( )

i f (now − lastMa intenanceMenuChange >= Common.MAINTENANCE_MENU_DELAY) { TUI . showMaintenanceMenu (
Common.MAINTENANCE_MENU_OPTIONS[ ma intenanceMenuIndex ]
)

ma intenanceMenuIndex =
( ma intenanceMenuIndex + 1 ) % Common.MAINTENANCE_MENU_OPTIONS. s i z e

lastMa intenanceMenuChange = now
}
}

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

32 i f ( s t a t i o n s . isEmpty ( ) ) return

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

va l key = wa itMa intenanceKey ( 5 0 0 0 )

i f ( ! Ma intenance . i s A c t i v e ( ) ) { return
}

when ( key ) {
KBD. none −> return

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

'#' −> return
}
}
}

pr ivate fun showCo inCounters ( ) {
va l c o i nV a l u e s = Common.COIN_VALUES

while ( Ma intenance . i s A c t i v e ( ) ) {
va l c o i n = c o i nV a l u e s [ ma int enan c eCo in Ind ex ] va l count = C o inD ep o s i t . getCo inCount ( c o i n )

TUI . showCo inCounter (
c o inV a lu e = c o in ,
numberCoins = count
)

va l key = wa itMa intenanceKey ( 5 0 0 0 )

i f ( ! Ma intenance . i s A c t i v e ( ) ) { return
}

when ( key ) {
KBD. none −> return

'A' −> {
ma int enan c eCo in Ind ex =
i f ( ma int enan c eCo in Ind ex == 0 ) { c o i nV a l u e s . l a s t I n d e x

33

} e l s e {
ma int enan c eCo in Ind ex − 1 }
}

'B' −> {
ma int enan c eCo in Ind ex =
( ma int enan c eCo in Ind ex + 1 ) % c o i nV a l u e s . s i z e }

'#' −> return
}
}
}

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

va l key = wa itMa intenanceKey ( 5 0 0 0 )

i f ( ! Ma intenance . i s A c t i v e ( ) ) { return
}

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

TUI . showCount ersR es et ( ) Thread . s l e e p ( 2 0 0 0 )
} e l s e {
TUI . showMa intenanceAborted ( ) Thread . s l e e p ( 1 5 0 0 )
}
}

pr ivate fun con f irmShutdown ( ) {
TUI . showShutdownCon f irmat ion ( )

va l key = wa itMa intenanceKey ( 5 0 0 0 )

i f ( ! Ma intenance . i s A c t i v e ( ) ) { return
}

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

TUI . showShutdown ( )
Thread . s l e e p ( 2 0 0 0 )

k o t l i n . system . e x i t P r o c e s s ( 0 ) } e l s e {
TUI . showMa intenanceAborted ( ) Thread . s l e e p ( 1 5 0 0 )
}
}

pr ivate fun wa itMa intenanceKey ( t im e ou t : Long ) : Char { va l endTime = System . c u r r e n t T im eM i l l i s ( ) + t im e ou t

34 while ( Ma intenance . i s A c t i v e ( ) && System . c u r r e n t T im eM i l l i s ( ) < endTime ) { va l key = KBD. getKey ( )

i f ( key != KBD. none ) {
return key
}

Thread . s l e e p ( 2 0 ) }

return KBD. none
}

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

TUI . sh owS t a t i onCh o i c e (
stat ionNumb er = s . number , stat ionName = s . name ,
oneWayPrice = s . oneWayPrice )
}

pr ivate fun drawPayment ( ) {
TUI . showPaymentScreen (
stat ionName = S t a t i o n s . c u r r e n t ( ) . name , roundTr ip = roundTr ip ,
r em a in in g = r em a i n i n g P r i c e
)
}

pr ivate fun wa itCo inRemova l ( ) { while ( Co inA c c eptor . hasCo in ( ) ) { Thread . s l e e p ( 2 0 )
}
}
}

fun main ( ) {
T icketMach ineApp . s t a r t ( ) }

B.2 M

Algoritmo 2: M

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

fun i s A c t i v e ( ) : Boo l ean {
return HAL. i s B i t (M_MASK)
}

35

}

B.3 TUI

Algoritmo 3: TUI

import j a v a . t im e . Loca lDateT ime

object TUI {

fun i n i t ( ) {
LCD. i n i t ( )
LCD. loadEuroSymbo l ( 0 ) LCD. loadArrowUp ( 1 )
LCD. loadArrowDown ( 2 )
KBD. i n i t ( )
}

fun getKey ( ) : Char = KBD. getKey ( )

fun waitAnyKey ( ) : Char {
while ( true ) {
va l k = KBD. getKey ( )
i f ( k != KBD. none ) return k Thread . s l e e p ( 5 0 )
}
}

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

va l t e x t = " % 0 2 d / % 0 2 d / % 0 4 d ␣ % 0 2 d : % 0 2 d " . format ( now . dayOfMonth ,
now . monthValue ,
now . year ,
now . hour ,
now . m inute
)

LCD. c u r s o r ( 1 , 0 )
LCD. w r i t e ( cu t 1 6 ( t e x t ) ) }

36 fun sh owS t a t i onCh o i c e ( stat ionNumb er : Int , stat ionNam e : String , oneWayPrice : Int ) { LCD. c l e a r ( )

LCD. c u r s o r ( 0 , 0 )
LCD. w r i t e ( c e n t e r ( stat ionNam e ) )

LCD. c u r s o r ( 1 , 0 )
LCD. w r i t e ( stat ionNumb er . t o S t r i n g ( ) . p adS t a r t ( 2 , ' 0 ' ) ) LCD. wr iteCharCode ( 1 )
LCD. wr iteCharCode ( 2 )

wr iteAmountR ight ( oneWayPrice )
}

fun showPaymentScreen ( stat ionNam e : String , roundTr ip : Boo lean , r em a in in g : Int ) { LCD. c l e a r ( )

LCD. c u r s o r ( 0 , 0 )
LCD. w r i t e ( c e n t e r ( stat ionNam e ) )

LCD. c u r s o r ( 1 , 0 )
LCD. wr iteCharCode ( 1 )

i f ( roundTr ip ) {
LCD. wr iteCharCode ( 2 )
}

wr iteAmountR ight ( r em a in in g ) }

fun sh owP r in t in g ( ) {
LCD. c l e a r ( )

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

fun sh owC an c e l edS a l e ( ) {
LCD. c l e a r ( )

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

fun showT i ck etFor ( stat ionNam e : String ) { LCD. c l e a r ( )

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

LCD. c u r s o r ( 1 , 0 )
LCD. w r i t e ( c e n t e r ( stat ionNam e ) )
}

fun showT icketReady ( stat ionName : String ) { LCD. c l e a r ( )

37

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

fun showThankYou ( ) {
LCD. c l e a r ( )

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

fun showMaintenanceMenu ( op t i onT ex t : String ) { LCD. c l e a r ( )

LCD. c u r s o r ( 0 , 0 )
LCD. w r i t e ( c e n t e r ( " M A N U T E N C A O " ) )

LCD. c u r s o r ( 1 , 0 )
LCD. w r i t e ( cu t 1 6 ( op t i onT ex t ) )
}

fun showMa intenanceTest (
stat ionNumb er : Int ,
stat ionNam e : String ,
p r i c e : Int ,
roundTr ip : Boo l ean
) {
LCD. c l e a r ( )

LCD. c u r s o r ( 0 , 0 )
LCD. w r i t e ( cu t 1 6 ( " T E S T E ␣ $ s t a t i o n N a m e " ) )

LCD. c u r s o r ( 1 , 0 )
LCD. w r i t e ( stat ionNumb er . t o S t r i n g ( ) . p adS t a r t ( 2 , ' 0 ' ) )

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

i f ( roundTr ip ) {
LCD. wr iteCharCode ( 2 )
}

wr iteAmountR ight ( p r i c e ) }

fun showT i ck etCount er (
stat ionNam e : String ,
s o l d T i c k e t s : Int
) {
LCD. c l e a r ( )

LCD. c u r s o r ( 0 , 0 )
LCD. w r i t e ( cu t 1 6 ( stat ionName ) )

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

38

}

fun showCo inCounter (
c o inV a lu e : Int ,
numberCoins : Int
) {
LCD. c l e a r ( )

LCD. c u r s o r ( 0 , 0 )
LCD. w r i t e ( " M o e d a : ␣ " )
LCD. w r i t e ( amountText ( c o inV a lu e ) ) LCD. wr iteCharCode ( 0 )

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

fun sh owR e s e tC on f i rm a t i on ( ) {
LCD. c l e a r ( )

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

fun showCount ersR es et ( ) {
LCD. c l e a r ( )

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

fun showShutdownCon f irmat ion ( ) { LCD. c l e a r ( )

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

fun showShutdown ( ) {
LCD. c l e a r ( )

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

}

fun showMa intenanceAborted ( ) { LCD. c l e a r ( )

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

39

}

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

LCD. c u r s o r ( 1 , s t a r t )
LCD. w r i t e ( t x t )
LCD. wr iteCharCode ( 0 )
}

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

return " ␣ " . r e p e a t ( l e f t ) + cu t
}

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

B.4 Coin Acceptor

Algoritmo 4: Coin Acceptor

object Co inA c c eptor {
pr ivate const va l COIN_MASK = 0x08 | // I3
pr ivate const va l CID_MASK = 0x07 | // I0 .. I2
pr ivate const va l ACCEPT_MASK = 0x10 | // O4
pr ivate const va l EJECT_MASK = 0x20 | // O5
pr ivate const va l COLLECT_MASK = 0x40 | // O6

fun i n i t ( ) {
HAL. c l r B i t s (ACCEPT_MASK o r EJECT_MASK o r COLLECT_MASK) }

fun hasCo in ( ) : Boo l ean {
return HAL. i s B i t (COIN_MASK) }

fun g e tCo inVa lu e ( ) : Int ? {
i f ( ! hasCo in ( ) ) return nu l l

return when (HAL. r e a d B i t s (CID_MASK) ) { 0 −> 5
1 −> 10
2 −> 20
3 −> 50
4 −> 100

40

5 −> 200
e l s e −> nu l l
}
}

fun a c c ep tC o in ( ) {
HAL. s e t B i t s (ACCEPT_MASK) Thread . s l e e p ( 2 0 0 )
HAL. c l r B i t s (ACCEPT_MASK) }

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

B.5 Coin Deposit

Algoritmo 5: Coin Deposit

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

i n s e r t e d C o i n s . c l e a r ( )
}

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

41

}

fun getCo inCount ( c o i n : Int ) : Int { return c o i nC o u n t e r s [ c o i n ] ? : 0 }

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

Algoritmo 6: File Access

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

object F i l e A c c e s s {

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

number++
}
}
}

return s t a t i o n s

42

}

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

c o i n s [ c o inV a lu e ] = numberCoins
}
}
}

return c o i n s
}

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

43
