leonardosilva-leic/ProjetoLIC-ISEL/Relatorios/moduloPortExpanderTD_LEIC22_G04.pdf

Keyboard Reader (Ticket Machine)
Laboratório de Informática e Computadores 2025 / 2026 verão Autores: David Velez / Nuno Sebastião / Pedro Miguens / Rogério Rebelo / Rui Duarte

## 1 Port Expander LCD

Para reduzir o número de ligações necessárias entre o módulo de controlo e o LCD, foi também utilizado o módulo Port Expander LCD (PELCD), responsável por receber informação em série e convertêla nos sinais paralelos exigidos pelo display. Esta abordagem permite separar os detalhes de baixo nível do hardware da lógica de controlo implementada em software.

### 1.1 Port Expander LCD (PELCD)

O módulo Port Expander LCD (PELCD) implementa a interface entre o software de controlo e o display LCD. De acordo com o enunciado do projeto, este módulo recebe a informação enviada em série pelo módulo Control e converte-a nos sinais paralelos necessários ao LCD, nomeadamente o sinal RS, os oito bits de dados e o sinal E. A utilização deste bloco justifica-se pela necessidade de reduzir o número de interligações físicas entre o PC e o hardware. Em vez de o software controlar diretamente todos os sinais paralelos do LCD, envia apenas uma trama série através de três linhas principais:
- LCDsel– sinal de seleção do periférico;
- SCLK– relógio da comunicação série;
- SDX– linha de dados série.
Segundo o diagrama do PELCD e o respetivo protocolo de comunicação, a mensagem enviada para este módulo é constituída por 10 bits de informação :
- Bit RS (bit 0): primeiro bit a ser enviado; indica se a mensagem é de controlo ou de dados para o LCD.
- Bits D0 a D7 (bits 1 a 8): oito bits de dados a entregar ao barramento de dados do LCD.
- Bit E (bit 9): último bit a ser recebido; corresponde ao sinal de enable responsável por desencadear o registo da informação no LCD.
No final, a linha SS efectua uma transição ascendente, sinalizando o fim da comunicação. Este evento é aproveitado internamente para capturar a palavra completa de 10 bits e disponibilizá-la de forma estável na saída paralela do módulo.
O início de cada transmissão é identificado por uma transição descendente em LCDsel, designada por condição de start. Depois disso, os bits são amostrados nas transições ascendentes do sinal

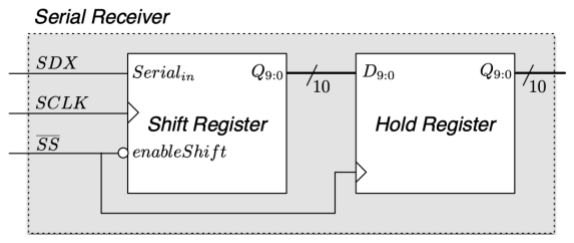
[picture p28: figure]

Figura 1: Diagrama de blocos do módulo SerialReceiver

SCLK. Internamente, o PELCD contém um bloco Serial Receiver, composto por um Shift Register e por um Hold Register, que recebem e mantêm a trama até esta ser disponibilizada ao LCD . Do ponto de vista do software, este funcionamento é explorado pelo módulo SerialEmitter, que envia bit a bit a trama necessária, e pelo módulo LCD, que organiza os comandos e dados segundo o protocolo esperado. Assim, o PELCD funciona como um elemento intermédio entre a comunicação série gerada em software e a interface paralela exigida pelo display físico.

### 1.2 SeriaReceiver

Foi implementado o bloco Serial Receiver conforme o diagrama de blocos da Figura 2. Este módulo é o núcleo funcional do sistema: coordena a recepção dos dados série e a sua conversão para um formato paralelo de 10 bits, para ser entregue ao LCD. A sua arquitectura é composta pela instanciação e interligação de dois sub-blocos: o ShiftRegister e o HoldRegister10bits. A comunicação entre eles é feita através de um barramento interno de 10 bits que transporta a palavra em construção durante a recepção da trama. Um aspecto central da lógica deste módulo é a geração do sinal de habilitação do deslocamento, designado enableShift no diagrama. Este sinal é obtido por inversão do sinal SS: quando a linha SS está em nível baixo (trama activa), o sinal invertido fica em nível alto, habilitando o ShiftRegister a receber e deslocar os bits à chegada de cada flanco ascendente de SCLK. Quando a mensagem termina e SS sobe, o deslocamento automaticamente acaba. A captura da palavra completa é feita de forma engenhosa: o sinal SS é ligado directamente ao relógio do Hol-

Keyboard Reader (Ticket Machine)
Laboratório de Informática e Computadores 2025 / 2026 verão Autores: David Velez / Nuno Sebastião / Pedro Miguens / Rogério Rebelo / Rui Duarte

dRegister. Assim, o flanco ascendente de SS, que marca o fim da mensagem, atua simultaneamente como pulso de relógio que captura a palavra de 10 bits presente na saída do ShiftRegister e a transfere para o HoldRegister, onde permanece estável até à próxima mensagem.

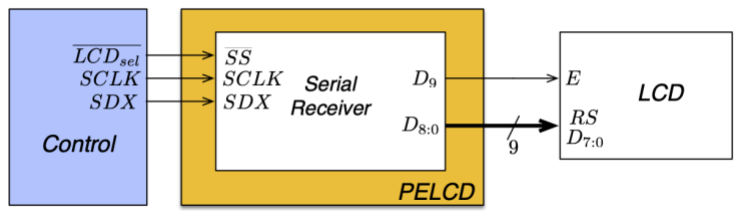
[picture p29: figure]

Figura 2: Diagrama de blocos do módulo Port Expander LCD (PELCD)

O módulo PELCD recebe em série uma mensagem constituída por dez (10) bits de informação. A comunicação com este módulo realiza-se segundo o protocolo ilustrado na Figura, em que o bit RS é o primeiro bit de informação e indica se a mensagem é de controlo ou dados. Os seguintes oito (8) bits contêm os dados a entregar ao LCD. O último bit contém o sinal de E responsável por registar a informação no LCD.

Figura 3: Protocolo de comunicação com o módulo Port Expander LCD (PELCD))

O emissor, realizado em software, quando pretende enviar uma trama para o módulo PELCD promove uma condição de início de trama (Start), que corresponde a uma transição descendente na linha (LCDsel). Após a condição de início, o módulo PELCD armazena os bits de dados da trama nas transições ascendentes do sinal SCLK. O bloco Serial Receiver do módulo PELCD é constituído por dois blocos principais: i) um registo de deslocamento; e ii) um registo de manutenção; designados por Shift Register e Hold Register respetivamente.

### 1.3 Shift Register

O registo de deslocamento de 10 bits é responsável por receber os dados do protocolo série e convertêlos numa palavra paralela. Internamente, o módulo é constituído por dez flip-flops D (FFD): a entrada série SDX alimenta o primeiro flip-flop, e a saída de cada flip-flop é ligada à entrada do seguinte, formando uma cadeia de deslocamento. Todos os flip-flops são sincronizados pelo sinal de relógio SCLK e partilham o mesmo sinal de habilitação enableShift (EN_shift), proveniente do SerialReceiver. Enquanto este sinal estiver activo, cada flanco ascendente de SCLK provoca o avanço de um bit na cadeia: o bit mais recente entra pelo primeiro flip-flop e todos os anteriores são deslocados uma posição.
Após dez ciclos de SCLK, a cadeia contém a totalidade dos 10 bits da mensagem. No entanto, o bit que entrou em primeiro lugar encontra-se no último flip-flop da cadeia. Para garantir que a saída paralela apresenta os bits na ordem correcta do protocolo, RS na posição 0, D0 na posição 1, e assim sucessivamente até E na posição 9, as saídas dos flip-flops são ligadas à saída do módulo em ordem inversa à da sua posição na cadeia.

### 1.4 Hold Register 10bits

O registo de manutenção de 10 bits, que papel é capturar a palavra paralela produzida pelo ShiftRegister no momento exacto em que a trama termina, e mantê-la estável na saída durante o intervalo entre mensagens. Ao contrário do ShiftRegister, em que os flip-flops estão encadeados, o HoldRegister é composto por dez flip-flops D completamente independentes entre si, cada um responsável por armazenar individualmente um bit do barramento de 10 bits. Não existe qualquer ligação entre flip-flops: cada um recebe directamente o bit correspondente da saída do ShiftRegister e captura-o no flanco ascendente do seu relógio. O relógio deste registo é o próprio sinal SS, conforme ligado pelo SerialReceiver. Desta forma, a ascendencia de SS, que ocorre no fim de cada mensagem, é o evento que provoca a captura simultânea dos 10 bits. A partir desse instante, a saída D[9:0] fica estável e disponível para o LCD consumir, mesmo que uma nova mensagem já esteja a ser recebida no ShiftRegister.

Keyboard Reader (Ticket Machine)
Laboratório de Informática e Computadores 2025 / 2026 verão Autores: David Velez / Nuno Sebastião / Pedro Miguens / Rogério Rebelo / Rui Duarte

## 2 Conclusões

O módulo PELCD assume um papel central na experiência do utilizador. O LCD é o principal meio de comunicação entre a máquina e quem a opera, sendo através dele que são apresentadas informações essenciais como o tipo de bilhete, o preço, o troco a devolver ou mensagens de estado do sistema. Sem um módulo de interface fiável e correcto entre o controlador e o LCD, toda a lógica de controlo da máquina ficaria sem forma de comunicar os seus resultados ao exterior, tornando o sistema inutilizável na prática.

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

## A VHDL

A.1 Port Expander LCD

library ieee;
use ieee.std_logic_1164.all;

entity PELCD is
port(
SS : in std_logic;
SCLK : in std_logic;
SDX | : in std_logic;
Rst | : in std_logic;
D | : out std_logic_vector(9 downto 0)
);

end PELCD;

architecture structural of PELCD is

component SerialReceiver is
port(
SDX | : in std_logic;
SCLK | : in std_logic;
SS | : in std_logic;
Rst | : in std_logic;
D | : out std_logic_vector(9 downto 0)
);

end component;

begin

SerialReceiver_V: serialReceiver port map(
SDX => SDX,
SCLK => SCLK,
SS | => SS,
Rst | => Rst,
D | => D
);

end structural;

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

A.2 Serial Receiver

library ieee;
use ieee.std_logic_1164.all;

entity SerialReceiver is
port(
SDX | : in std_logic;
SCLK | : in std_logic;
SS | : in std_logic;
Rst | : in std_logic;
D | : out std_logic_vector(9 downto 0)
);

end SerialReceiver;

architecture structural of SerialReceiver is

component ShiftRegister is
port(
Serial_in : in std_logic;
EN_shift | : in std_logic;
SCLK | : in std_logic;
Rst | : in std_logic;
Q_OUT | : out std_logic_vector(9 downto 0)
);

end component;

component HoldRegister10bits is port(
CLK | : in | STD_LOGIC;
Rst | : in | STD_LOGIC;
SET | : in | STD_LOGIC;
EN | : in | STD_LOGIC;
D_IN | : in | STD_LOGIC_VECTOR(9 downto 0);
Q_OUT : out STD_LOGIC_VECTOR(9 downto 0) );

end component;

signal s_D_in : std_logic_vector(9 downto 0); signal s_not_ss : std_logic;

begin

ShiftRegister_V : ShiftRegister port map(
Serial_in => SDX,
EN_shift | => s_not_ss,
SCLK | => SCLK,
Rst | => Rst,
Q_OUT | => s_D_in
);

HoldRegister_V : HoldRegister10bits port map(
CLK | => SS,
Rst | => Rst,
SET | => '0',
EN | => '1',
D_IN | => s_D_in,
Q_OUT => D
);

s_not_ss <= not SS;

end structural;

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

A.3 Shift Register

library ieee;
use ieee.std_logic_1164.all;

entity ShiftRegister is
port(
Serial_in : in std_logic;
EN_shift | : in std_logic;
SCLK | : in std_logic;
Rst | : in std_logic;
Q_OUT | : out std_logic_vector(9 downto 0)
);

end ShiftRegister;

architecture structural of ShiftRegister is

component FFD is
port(
CLK | : in | STD_LOGIC;
Rst | : in | STD_LOGIC;
SET | : in | STD_LOGIC;
D | : in | STD_LOGIC;
EN | : in | STD_LOGIC;
Q | : out STD_LOGIC
);

end component;

signal Q_s : std_logic_vector(9 downto 0);

begin

FF0 : FFD
PORT MAP (
CLK => SCLK,
Rst => Rst,
SET | => '0',
EN | => EN_shift,
D | => Serial_in,
Q | => Q_s(0)
);

FF1 : FFD
PORT MAP (
CLK | => SCLK,
Rst | => Rst,
SET | => '0',
EN | => EN_shift,
D | => Q_s(0),
Q | => Q_s(1)
);

FF2 : FFD
PORT MAP (
CLK | => SCLK,
Rst | => Rst,
SET | => '0',
EN | => EN_shift,
D | => Q_s(1),
Q | => Q_s(2)
);

FF3 : FFD
PORT MAP (
CLK | => SCLK,
Rst | => Rst,
SET | => '0',
EN | => EN_shift,
D | => Q_s(2),

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

A.4 Hold Register 10bits

LIBRARY ieee;
USE ieee.std_logic_1164.all;

ENTITY HoldRegister10bits IS PORT(
CLK | : in | STD_LOGIC;
Rst | : in | STD_LOGIC;
SET | : in | STD_LOGIC;
EN | : in | STD_LOGIC;
D_IN | : in | STD_LOGIC_VECTOR(9 downto 0);
Q_OUT : out STD_LOGIC_VECTOR(9 downto 0) );
END HoldRegister10bits;

ARCHITECTURE structural OF HoldRegister10bits IS

COMPONENT FFD IS
PORT(
CLK | : in | STD_LOGIC;
Rst | : in | STD_LOGIC;
SET | : in | STD_LOGIC;
D | : in | STD_LOGIC;
EN | : in | STD_LOGIC;
Q | : out STD_LOGIC
);
END COMPONENT;

BEGIN

FF0 : FFD
PORT MAP (
CLK | => CLK,
Rst | => Rst,
SET | => '0',
EN | => '1',
D | => D_IN(0),
Q | => Q_OUT(0)
);

FF1 : FFD
PORT MAP (
CLK | => CLK,
Rst | => Rst,
SET | => '0',
EN | => '1',
D | => D_IN(1),
Q | => Q_OUT(1)
);

FF2 : FFD
PORT MAP (
CLK | => CLK,
Rst | => Rst,
SET | => '0',
EN | => '1',
D | => D_IN(2),
Q | => Q_OUT(2)
);

FF3 : FFD
PORT MAP (
CLK | => CLK,
Rst | => Rst,
SET | => '0',
EN | => '1',
D | => D_IN(3),
Q | => Q_OUT(3)
);

FF4 : FFD
PORT MAP (

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

## B Kotlin

B.1 TUI

Algoritmo 1: TUI - Hardware Abstract Layer

object TUI {

va l Column = 16
var Text = " "

fun i n i t ( ) {
KBD. i n i t ( )
LCD. i n i t ( )
LCD. c l e a r ( )
}

fun run ( ) {
while ( true ) {
va l key = KBD. getKey ( )

i f ( key != KBD. none ) {
i f ( key == '# ') {
Text = " "
} e l s e i f ( key == 'C' ) {
Text += " B i l h e t e ␣ p a r a ␣ o ␣ ␣ c a r a l h o ? " } e l s e {
Text += key
}

LCD. c l e a r ( )
va l l en g thT e x t = Text . l e n g t h

i f ( l en g thT e x t <= Column) { LCD. c u r s o r ( 0 , 0 )
LCD. w r i t e ( Text )
}

e l s e {

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

va l lowText = Text . s u b s t r i n g ( Column)

va l emptySpace = Column − lowText . l e n g t h va l f i r s tC o l um n = emptySpace / 2

LCD. c u r s o r ( 1 , f i r s tC o l um n )
LCD. w r i t e ( lowText )
}
}
}
}
}
fun main ( ) {

TUI . i n i t ( )
TUI . run ( )
}
B.2 Serial Emitter

Algoritmo 2: SerialEmmitter

import i s e l . l e i c . u t i l s . Time

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

Keyboard Reader (Ticket Machine)
Laboratório de Informática e Computadores 2025 / 2026 verão Autores: David Velez / Nuno Sebastião / Pedro Miguens / Rogério Rebelo / Rui Duarte
pr ivate const va l SDX_MASK = 0x01 | // O0
pr ivate const va l SCLK_MASK = 0x02 | // O1
pr ivate const va l LCDSEL_MASK = 0x04 | // O2
pr ivate const va l TICKETSEL_MASK = 0x08 // O3

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

pr ivate fun sendLCD( data : Int ) { HAL. s e t B i t s (LCDSEL_MASK) HAL. c l r B i t s (SCLK_MASK)

HAL. c l r B i t s (LCDSEL_MASK)

fo r ( i in 0 . . 9 ) {
HAL. c l r B i t s (SCLK_MASK)

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

Time . s l e e p ( 1 )
HAL. s e t B i t s (SCLK_MASK)
Time . s l e e p ( 1 )
}

HAL. c l r B i t s (SCLK_MASK)
HAL. s e t B i t s (LCDSEL_MASK)
}

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

HAL. c l r B i t s (TICKETSEL_MASK)

fo r ( i in 0 . . 9 ) {
HAL. c l r B i t s (SCLK_MASK)

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

Time . s l e e p ( 1 )
HAL. s e t B i t s (SCLK_MASK)
Time . s l e e p ( 1 )
}

HAL. c l r B i t s (SCLK_MASK)
HAL. s e t B i t s (TICKETSEL_MASK)

}

fun i sBu s y ( ) : Boo lean = f a l s e }

B.3 LCD

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

Algoritmo 3: LCD - Hardware Abstract Layer

import i s e l . l e i c . u t i l s . Time

object LCD {
const va l LINES = 2
const va l COLS = 16

pr ivate const va l FUNCTION_SET = 0x38 pr ivate const va l DISPLAY_ON = 0x0C pr ivate const va l ENTRY_MODE = 0x06 pr ivate const va l CLEAR_DISPLAY = 0x01
pr ivate const va l SET_DDRAM = 0x80

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

pr ivate fun writeCMD( data : Int ) { w r i t eB y t e ( f a l s e , data )
}

pr ivate fun writeDATA ( data : Int ) { w r i t eB y t e ( true , data )
}

fun i n i t ( ) {
S e r i a l E m i t t e r . i n i t ( )

Time . s l e e p ( 5 0 )
writeCMD( 0 x30 )
Time . s l e e p ( 5 )
writeCMD( 0 x30 )
Time . s l e e p ( 1 )
writeCMD( 0 x30 )
Time . s l e e p ( 1 )

writeCMD(FUNCTION_SET)
writeCMD(DISPLAY_ON)
writeCMD(ENTRY_MODE)
c l e a r ( )
}

fun w r i t e ( c : Char ) { writeDATA ( c . cod e )
}

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

fun c l e a r ( ) {
writeCMD(CLEAR_DISPLAY)
Time . s l e e p ( 2 )

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

}

pr ivate const va l SET_CGRAM = 0x40

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

writeCMD(SET_CGRAM o r ( l o c s h l 3 ) )

fo r ( i in 0 u n t i l 8 ) {
writeDATA ( p a t t e r n [ i ] and 0x1F ) }
}

fun wr iteCharCode ( cod e : Int ) { writeDATA ( cod e and 0xFF)
}

fun loadEuroSymbo l ( l o c a t i o n : Int = 0 ) { va l eu r o = in tA r r ayO f (
0b01110 ,
0b10001 ,
0b11100 ,
0b10000 ,
0b11100 ,
0b10001 ,
0b01110 ,
0b00000
)
c r e a t eC h a r ( l o c a t i o n , eu r o ) }
}

fun main ( ) {
LCD. i n i t ( )
LCD. loadEuroSymbo l ( 0 ) LCD. c u r s o r ( 0 , 0 )
LCD. w r i t e ( " O l a " )
LCD. c u r s o r ( 1 , 0 )
LCD. w r i t e ( " 4 ,00 " ) LCD. wr iteCharCode ( 0 )
}
B.4 Serial Receiver

Algoritmo 4: SerialReceiver

import i s e l . l e i c . u t i l s . Time

const va l INVALID_KEYCODE = −1

object S e r i a l R e c e i v e r {

pr ivate const va l RXD_MASK = 0x80 | // I7
pr ivate const va l RXCLK_MASK = 0x80 | // O7

pr ivate const va l HALF_CLOCK_MS = 2L
pr ivate const va l SAMPLE_DELAY_MS = 2L
pr ivate const va l FRAME_END_DELAY_MS = 2L

fun i n i t ( ) {
HAL. c l r B i t s (RXCLK_MASK)
}

fun r c v ( ) : Int {
// s e m t r a m a
i f (HAL. i s B i t (RXD_MASK) ) return INVALID_KEYCODE

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

Time . s l e e p (SAMPLE_DELAY_MS)
i f ( !HAL. i s B i t (RXD_MASK) ) return INVALID_KEYCODE

// c l o c k s 2 . . 5 : K0 .. K3
var keyCode = 0
fo r ( i in 0 . . 3 ) {
p u l s eC l o c k ( )
Time . s l e e p (SAMPLE_DELAY_MS)

i f (HAL. i s B i t (RXD_MASK) ) {
keyCode = keyCode o r ( 1 s h l i ) }
}

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

return keyCode
}

fun wa itRcv ( ) : Int {
while (HAL. i s B i t (RXD_MASK) ) { Time . s l e e p ( 1 )
}
return r c v ( )
}

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
