leonardosilva-leic/ProjetoLIC-ISEL/Relatorios/moduloPortExpanderTD_LEIC22_G04 (1).pdf

### Port Expander Ticket Dispenser (Ticket Machine)

Laboratório de Informática e Computadores 2025 / 2026 verão Autores: Beatriz Leme / Leonardo Silva / Miguel Ruivo

### Neste caso o módulo Control, implementado em software, é a entidade consumidora. O módulo Port Expander Ticket Dispenser (PETD) implementa a interface com o mecanismo de impressão de bilhetes (Ticket Dispenser ), realizando a receção em série da informação enviada pelo módulo de con-

trolo e entregando-a posteriormente ao mecanismo, conforme representado na Figura 1.

### O módulo PETD recebe em série uma mensagem composta por dez (10) bits de informação, segundo

o protocolo de comunicação ilustrado na Figura 2b.

### O primeiro bit de informação indica se o bilhete a imprimir é de ida ou ida/volta. Os quatro bits seguintes indicam a estação de origem, seguido da

estação de destino por mais 4 bits de informação.

### O último bit de informação indica o início da impressão e disponibilização do bilhete. Só pode ser iniciada nova impressão quando o mecanismo de dispensa de bilhetes informar o Control que o pro-

cesso terminou através do sinal Fn.

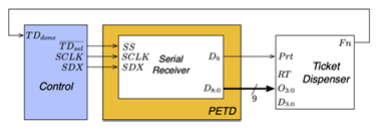
[picture p30: figure]

Figura 1: Diagrama de blocos do módulo Port Expander Ticket Dispenser

# 1 Serial Receiver

O módulo Serial Receiver é responsável pela receção e descodificação de dados transmitidos, convertendo a informação recebida sequencialmente num barramento paralelo de saída de dez bits. Estruturalmente, a arquitetura do componente é composta por dois sub-blocos: por um Shift Register que é um registo de deslocamento e um Hold Register de 10 bits que é um registo de contenção como

mostra a Figura 2a.

### O bloco Shift Register é responsável por receber sequencialmente os bits do sinal de entrada série SDX. O varrimento e o deslocamento interno dos dados ocorrem à cadência do SCLK sempre que o EN shift se encontra ativo. O bloco conta ainda com uma entrada de reset (Rst) para repor os val-

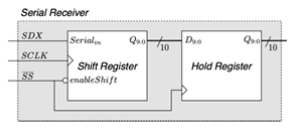
[picture p31: figure]

(a) Diagrama de blocos
(b) Diagrama temporal

Figura 2: Bloco PETD

### ores do registo, disponibilizando a palavra binária

resultante de dez bits na saída Q OUT.

Já o bloco Hold Register10bits implementa a lógica de retenção de dados, sendo responsável por armazenar de forma estável o vetor de dez bits proveniente do Shift Register (D IN ). O armazenamento e a transferência da informação para o barramento de saída D são controlados de forma síncrona através das entradas CLK, SET e EN, sendo o fluxo global coordenado em consonância com o sinal de seleção SS. Este mecanismo garante que os dados de saída permaneçam válidos e imutáveis durante os ciclos de receção de novas tramas no barramento

série.

### A descrição hardware do bloco PETD em VHDL

encontra-se no Anexo A.1.1.

# 2 Ticket Dispenser

O Ticket Dispenser recebe em 4 bits o código da estação de destino (D3:0), noutros 4 bits o código da estação de origem (O3:0) a imprimir no bilhete e ainda o bit RT que define o tipo de bilhete (ida ou ida/volta). O comando de impressão do bilhete com os códigos presentes em D, O e RT é realizado pela ativação do sinal de impressão (Prt). Em resposta, o Ticket Dispenser ativa o sinal de término de execução (Fn) quando concluída a dispensa do bilhete.Este componete foi fornecido pelos docentes

atravéz da paltaforma moodle.

# 3 Conclusões

### Com a realização deste projeto, foi possível projetar e implementar com sucesso o módulo Serial Re-

### Port Expander Ticket Dispenser (Ticket Machine)

Laboratório de Informática e Computadores 2025 / 2026 verão Autores: Beatriz Leme / Leonardo Silva / Miguel Ruivo

### ceiver em lógica programável (VHDL), cumprindo integralmente todos os requisitos especificados. A arquitetura modular implementada revelou-se uma solução robusta e adequada para receber dados por via série através do sinal SDX e disponibilizar a

informação no barramento de dez bits.

A validação do circuito foi efetuada recorrendo a Testbenchs e posterior teste em laboratório na placa de desenvolvimento DE10 Lite. O comportamento verificado nas simulações temporais está de acordo com o previsto, demonstrando que o varrimento e o deslocamento interno ocorrem corretamente à cadência SCLK sempre que o sinal de habilitação EN shift se encontra ativo. O mecanismo de retenção controlado pelos sinais CLK, SET e EN garantiu que os dados de saída permanecessem es-

táveis e válidos durante a receção de novas tramas.

### Port Expander Ticket Dispenser (Ticket Machine)

Laboratório de Informática e Computadores 2025 / 2026 verão Autores: Beatriz Leme / Leonardo Silva / Miguel Ruivo

# A VHDL

A.1 | PETD
A.1.1 | PETD

library ieee;
use ieee.std_logic_1164.all;

entity PETD is
port(
SS : in std_logic;
SCLK : in std_logic;
SDX | : in std_logic;
Rst | : in std_logic;
RT | : out std_logic;
Prt | : out std_logic;
O | : out std_logic_vector(8 downto 5);
D | : out std_logic_vector(4 downto 1)
);

end PETD;

architecture structural of PETD is

component SerialReceiver is port(
SDX | : in std_logic;
SCLK | : in std_logic;
SS | : in std_logic;
Rst | : in std_logic;
D | : out std_logic_vector(9 downto 0)
);

end component;

signal s_D_out : std_logic_vector(9 downto 0);

begin

SerialReceiver_V: serialReceiver port map(
SDX => SDX,
SCLK => SCLK,
SS | => SS,
Rst | => Rst,
D | => s_D_out
);
Prt | <= s_D_out(0);
D | <= s_D_out(4 downto 1);
O | <= s_D_out(8 downto 5);
RT | <= s_D_out(9);

end structural;

### Port Expander Ticket Dispenser (Ticket Machine)

Laboratório de Informática e Computadores 2025 / 2026 verão Autores: Beatriz Leme / Leonardo Silva / Miguel Ruivo

### Port Expander Ticket Dispenser (Ticket Machine)

Laboratório de Informática e Computadores 2025 / 2026 verão Autores: Beatriz Leme / Leonardo Silva / Miguel Ruivo

### A.1.2 Serial Receiver

library ieee;
use ieee.std_logic_1164.all;

entity SerialReceiver is
port(
SDX | : in std_logic;
SCLK | : in std_logic;
SS | : in std_logic;
Rst | : in std_logic;
D | : out std_logic_vector(9 downto 0)
);

end SerialReceiver;

architecture structural of SerialReceiver is

component ShiftRegister is
port(
Serial_in : in std_logic;
EN_shift | : in std_logic;
SCLK | : in std_logic;
Rst | : in std_logic;
Q_OUT | : out std_logic_vector(9 downto 0)
);

end component;

component HoldRegister10bits is port(
CLK | : in | STD_LOGIC;
Rst | : in | STD_LOGIC;
SET | : in | STD_LOGIC;
EN | : in | STD_LOGIC;
D_IN | : in | STD_LOGIC_VECTOR(9 downto 0);
Q_OUT : out STD_LOGIC_VECTOR(9 downto 0) );

end component;

signal s_D_in : std_logic_vector(9 downto 0); signal s_not_ss : std_logic;

begin

ShiftRegister_V : ShiftRegister port map(
Serial_in => SDX,
EN_shift | => s_not_ss,
SCLK | => SCLK,
Rst | => Rst,
Q_OUT | => s_D_in
);

HoldRegister_V : HoldRegister10bits port map(
CLK | => SS,
Rst | => Rst,
SET | => '0',
EN | => '1',
D_IN | => s_D_in,
Q_OUT => D
);

s_not_ss <= not SS;

end structural;

### Port Expander Ticket Dispenser (Ticket Machine)

Laboratório de Informática e Computadores 2025 / 2026 verão Autores: Beatriz Leme / Leonardo Silva / Miguel Ruivo

### Port Expander Ticket Dispenser (Ticket Machine)

Laboratório de Informática e Computadores 2025 / 2026 verão Autores: Beatriz Leme / Leonardo Silva / Miguel Ruivo

### A.1.3 Shift Register

library ieee;
use ieee.std_logic_1164.all;

entity ShiftRegister is
port(
Serial_in : in std_logic;
EN_shift | : in std_logic;
SCLK | : in std_logic;
Rst | : in std_logic;
Q_OUT | : out std_logic_vector(9 downto 0)
);

end ShiftRegister;

architecture structural of ShiftRegister is

component FFD is
port(
CLK | : in | STD_LOGIC;
Rst | : in | STD_LOGIC;
SET | : in | STD_LOGIC;
D | : in | STD_LOGIC;
EN | : in | STD_LOGIC;
Q | : out STD_LOGIC
);

end component;

signal Q_s : std_logic_vector(9 downto 0);

begin

FF0 : FFD
PORT MAP (
CLK => SCLK,
Rst => Rst,
SET | => '0',
EN | => EN_shift,
D | => Serial_in,
Q | => Q_s(0)
);

FF1 : FFD
PORT MAP (
CLK | => SCLK,
Rst | => Rst,
SET | => '0',
EN | => EN_shift,
D | => Q_s(0),
Q | => Q_s(1)
);

FF2 : FFD
PORT MAP (
CLK | => SCLK,
Rst | => Rst,
SET | => '0',
EN | => EN_shift,
D | => Q_s(1),
Q | => Q_s(2)
);

FF3 : FFD
PORT MAP (
CLK | => SCLK,
Rst | => Rst,
SET | => '0',
EN | => EN_shift,
D | => Q_s(2),

### Port Expander Ticket Dispenser (Ticket Machine)

Laboratório de Informática e Computadores 2025 / 2026 verão Autores: Beatriz Leme / Leonardo Silva / Miguel Ruivo

### Port Expander Ticket Dispenser (Ticket Machine)

Laboratório de Informática e Computadores 2025 / 2026 verão Autores: Beatriz Leme / Leonardo Silva / Miguel Ruivo

### A.1.4 Hold Register

LIBRARY ieee;
USE ieee.std_logic_1164.all;

ENTITY HoldRegister10bits IS PORT(
CLK | : in | STD_LOGIC;
Rst : in | STD_LOGIC;
SET | : in | STD_LOGIC;
EN | : in | STD_LOGIC;
D_IN | : in | STD_LOGIC_VECTOR(9 downto 0);
Q_OUT : out STD_LOGIC_VECTOR(9 downto 0) );
END HoldRegister10bits;

ARCHITECTURE structural OF HoldRegister10bits IS

COMPONENT FFD IS
PORT(
CLK | : in | STD_LOGIC;
Rst : in | STD_LOGIC;
SET | : in | STD_LOGIC;
D | : in | STD_LOGIC;
EN | : in | STD_LOGIC;
Q | : out STD_LOGIC
);
END COMPONENT;

BEGIN

FF0 : FFD
PORT MAP (
CLK => CLK,
Rst => Rst,
SET | => '0',
EN | => '1',
D | => D_IN(0),
Q | => Q_OUT(0)
);

FF1 : FFD
PORT MAP (
CLK | => CLK,
Rst | => Rst,
SET | => '0',
EN | => '1',
D | => D_IN(1),
Q | => Q_OUT(1)
);

FF2 : FFD
PORT MAP (
CLK | => CLK,
Rst | => Rst,
SET | => '0',
EN | => '1',
D | => D_IN(2),
Q | => Q_OUT(2)
);

FF3 : FFD
PORT MAP (
CLK | => CLK,
Rst | => Rst,
SET | => '0',
EN | => '1',
D | => D_IN(3),
Q | => Q_OUT(3)
);

FF4 : FFD
PORT MAP (

### Port Expander Ticket Dispenser (Ticket Machine)

Laboratório de Informática e Computadores 2025 / 2026 verão Autores: Beatriz Leme / Leonardo Silva / Miguel Ruivo

### A.1.5 Flip Flop

LIBRARY ieee;
USE ieee.std_logic_1164.all;

ENTITY FFD IS
PORT(
CLK : in std_logic;
Rst : in STD_LOGIC;
SET : in std_logic;
D : IN STD_LOGIC;
EN : IN STD_LOGIC;
Q : out std_logic
);
END FFD;

ARCHITECTURE logicFunction OF FFD IS

BEGIN

Q <= '0' when Rst = '1' else '1' when SET = '1' else D WHEN rising_edge(clk) and EN = '1';

END LogicFunction;

### Port Expander Ticket Dispenser (Ticket Machine)

Laboratório de Informática e Computadores 2025 / 2026 verão Autores: Beatriz Leme / Leonardo Silva / Miguel Ruivo

### Port Expander Ticket Dispenser (Ticket Machine)

Laboratório de Informática e Computadores 2025 / 2026 verão Autores: Beatriz Leme / Leonardo Silva / Miguel Ruivo

A.2 | Ticket Dispenser (Fornecido pelos Docentes)
A.2.1 | ticketDispenser

LIBRARY IEEE;
use IEEE.STD_LOGIC_1164.all;

-- RT bit indicates either is a one-way ticket (1) or a two-way ticket (0) -- D - Destination Station Code
-- O - Origin Station Code
entity TICKET_DISPENSER is
| port ( RT, Prt, CollectTicket: in STD_LOGIC; O, D: in STD_LOGIC_VECTOR(3 downto 0); Fn: out STD_LOGIC; HEX0, HEX1, HEX2, HEX3, HEX4, HEX5: out STD_LOGIC_VECTOR(7 downto 0) );

end TICKET_DISPENSER;

architecture arq_TICKET_DISPENSER of TICKET_DISPENSER is

component DECODERHEX

| port ( A: in STD_LOGIC_VECTOR(3 downto 0); ewr: in STD_LOGIC_VECTOR(7 downto 0); clear: in STD_LOGIC; HEX0: out STD_LOGIC_VECTOR(7 downto 0) );

end component;

signal RTtoBDC: STD_LOGIC_VECTOR(3 downto 0);

begin

| -- Activate Fn when client retrieves the printed ticket Fn <= CollectTicket; -- Convert RT bit to BDC RTtoBDC <= "0000" when RT = '1' else "0001"; -- Using the six 7 segment displays available on the MAX10 Lite Board -- produce a valid array of numbers and letters which the client can understand -- Valid format example: [b0o1d4] -- Means: "bilhete de ida e volta, da estação de origem com o código (0001) para a estação de destino com o código (0100) -- Implementation on the six 7 displays segment, facing the board, starting from the right to the left: U0: DECODERHEX port map ( A => D, ewr => "11111111", clear => not Prt, HEX0 => HEX4 ); U1: DECODERHEX port map ( -- Always d in BDC A => "1101", ewr => "11111111", clear => '0', HEX0 => HEX5 ); U2: DECODERHEX port map ( A => O, ewr => "11111111", clear => not Prt, HEX0 => HEX2 ); U3: DECODERHEX port map ( A => "0000", -- A value assignment is redundant here, since the value in ewr will overwrite it, because its different from "11111111" -- Always o, which has no representation in BDC ewr => "10100011", clear => '0', HEX0 => HEX3 ); U4: DECODERHEX port map ( -- RT bit in BDC

### Port Expander Ticket Dispenser (Ticket Machine)

Laboratório de Informática e Computadores 2025 / 2026 verão Autores: Beatriz Leme / Leonardo Silva / Miguel Ruivo

### A.2.2 int7seg

LIBRARY IEEE;
USE IEEE.STD_LOGIC_1164.all;

entity INT7SEG is

port( | d: in STD_LOGIC_VECTOR(3 downto 0);
ewr: in STD_LOGIC_VECTOR(7 downto 0); dOut: out STD_LOGIC_VECTOR(7 downto 0) );

end INT7SEG;

architecture logicFunction of INT7SEG is

begin

-- ewr stands for enable write, which will let the user directly set values for each LED avalaible in a 7 display segment

dOut <= | ewr when ewr /= "11111111" else
"11000000" when d = "0000" else "11111001" when d = "0001" else "10100100" when d = "0010" else "10110000" when d = "0011" else "10011001" when d = "0100" else "10010010" when d = "0101" else "10000010" when d = "0110" else "11111000" when d = "0111" else "10000000" when d = "1000" else "10011000" when d = "1001" else "10001000" when d = "1010" else -- A "10000011" when d = "1011" else -- B "11000110" when d = "1100" else -- C
"10100001" when d = "1101" else -- D
"10000110" when d = "1110" else -- E
"10001110"; | -- F

end logicFunction;

### Port Expander Ticket Dispenser (Ticket Machine)

Laboratório de Informática e Computadores 2025 / 2026 verão Autores: Beatriz Leme / Leonardo Silva / Miguel Ruivo

### A.2.3 decoderHex

LIBRARY IEEE;
use IEEE.std_logic_1164.all;

entity DECODERHEX is

port ( A: in STD_LOGIC_VECTOR(3 downto 0); ewr: in STD_LOGIC_VECTOR(7 downto 0); clear: in STD_LOGIC;
HEX0: out STD_LOGIC_VECTOR(7 downto 0) );

end DECODERHEX;

architecture logicFuntion of DECODERHEX is

component INT7SEG

port( | d: in STD_LOGIC_VECTOR(3 downto 0);
ewr: in STD_LOGIC_VECTOR(7 downto 0); dOut: out STD_LOGIC_VECTOR(7 downto 0) );

end component;

signal HEX0t: STD_LOGIC_VECTOR(7 downto 0);

begin

U0: int7seg port map(A, ewr, HEX0t);

HEX0 <= HEX0t when clear = '0' else "11111111";

end logicFuntion;

### Port Expander Ticket Dispenser (Ticket Machine)

Laboratório de Informática e Computadores 2025 / 2026 verão Autores: Beatriz Leme / Leonardo Silva / Miguel Ruivo

# B Kotlin

## B.1 Serial Emitter

Algoritmo 1: Serial Emitter

import i s e l . l e i c . u t i l s . Time

object S e r i a l E m i t t e r {
enum c l a s s P e r i p h e r a l { LCD, TICKET }
pr ivate const va l SDX_MASK = 0x01 | // O0
pr ivate const va l SCLK_MASK = 0x02 | // O1
pr ivate const va l LCDSEL_MASK = 0x04 | // O2
pr ivate const va l TICKETSEL_MASK = 0x08 // O3

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

pr ivate fun sendLCD( data : Int ) { HAL. s e t B i t s (LCDSEL_MASK) HAL. c l r B i t s (SCLK_MASK)

HAL. c l r B i t s (LCDSEL_MASK)

fo r ( i in 0 . . 9 ) {
HAL. c l r B i t s (SCLK_MASK)

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

Time . s l e e p ( 1 )
HAL. s e t B i t s (SCLK_MASK)
Time . s l e e p ( 1 )
}

HAL. c l r B i t s (SCLK_MASK)
HAL. s e t B i t s (LCDSEL_MASK)
}

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

HAL. c l r B i t s (TICKETSEL_MASK)

fo r ( i in 0 . . 9 ) {
HAL. c l r B i t s (SCLK_MASK)

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

Time . s l e e p ( 1 )
HAL. s e t B i t s (SCLK_MASK)
Time . s l e e p ( 1 )
}

### Port Expander Ticket Dispenser (Ticket Machine)

Laboratório de Informática e Computadores 2025 / 2026 verão Autores: Beatriz Leme / Leonardo Silva / Miguel Ruivo

HAL. c l r B i t s (SCLK_MASK)
HAL. s e t B i t s (TICKETSEL_MASK)

}

fun i sBu s y ( ) : Boo lean = f a l s e }

## B.2 Serial Receiver

Algoritmo 2: Serial Receiver

import i s e l . l e i c . u t i l s . Time

const va l INVALID_KEYCODE = −1

object S e r i a l R e c e i v e r {

pr ivate const va l RXD_MASK = 0x80 | // I7
pr ivate const va l RXCLK_MASK = 0x80 | // O7

pr ivate const va l HALF_CLOCK_MS = 2L
pr ivate const va l SAMPLE_DELAY_MS = 2L
pr ivate const va l FRAME_END_DELAY_MS = 2L

fun i n i t ( ) {
HAL. c l r B i t s (RXCLK_MASK)
}

fun r c v ( ) : Int {
// s e m t r a m a
i f (HAL. i s B i t (RXD_MASK) ) return INVALID_KEYCODE

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

// c l o c k s 2 . . 5 : K0 .. K3
var keyCode = 0
fo r ( i in 0 . . 3 ) {
p u l s eC l o c k ( )
Time . s l e e p (SAMPLE_DELAY_MS)

i f (HAL. i s B i t (RXD_MASK) ) {
keyCode = keyCode o r ( 1 s h l i ) }
}

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

return keyCode
}

### Port Expander Ticket Dispenser (Ticket Machine)

Laboratório de Informática e Computadores 2025 / 2026 verão Autores: Beatriz Leme / Leonardo Silva / Miguel Ruivo

fun wa itRcv ( ) : Int {
while (HAL. i s B i t (RXD_MASK) ) { Time . s l e e p ( 1 )
}
return r c v ( )
}

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

## B.3 TD

Algoritmo 3: Ticket Dispenser

object TD {

fun i n i t ( ) {
S e r i a l E m i t t e r . i n i t ( )
}

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

fun main ( ) {
TD. i n i t ( )

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

p r i n t l n ( " F i m ␣ d o s ␣ t e s t e s " )
}
