leonardosilva-leic/ProjetoLIC-ISEL/Manuais/de10-Lite Exp. Board v1.0 - Reference Manual.pdf

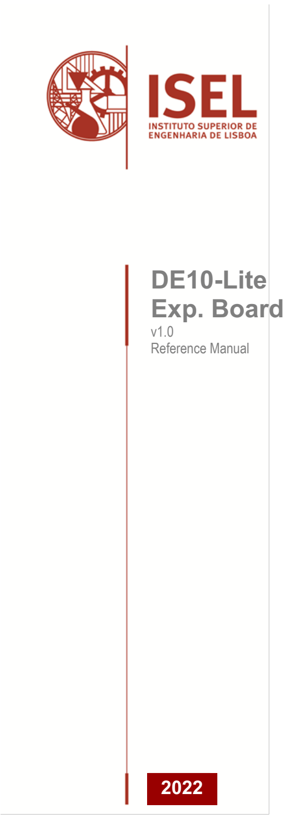
[picture p32: page 1]

# DE10-Lite Exp. Board

v1.0

### Reference Manual

2022

DE10-LITE EXP. BOARD – REFERENCE MANUAL | AAA.BB.CC.DD: NOME DO REGULAMENTO
1/11 | Rua Conselheiro Emídio Navarro 1 1959-007 Lisboa- Portugal Tel: (+351) 218 317 000 Fax: (+351) 218 317 162 Web: www.isel.pt
Title: | DE10-Lite Exp. Board – Reference manual
Execution: | Pedro Miguens Matutino

Coordination: Pedro Miguens Matutino

Edition: | ISEL
Date: | april 2022, revision may 2022
Location: | ISEL - Instituto Superior de Engenharia de Lisboa
| Rua Conselheiro Emídio Navarro, 1
| 1959-007 Lisboa

Instituto Superior de Engenharia de Lisboa (ISEL) is disclosing this user guide, manual, release note, and/or specification (the "Documentation") to you solely for use in the development of designs to operate with ISEL hardware devices. You may not reproduce, distribute, republish, download, display, post, or transmit the Documentation in any form or by any means including, but not limited to, electronic, mechanical, photocopying, recording, or otherwise, without the prior written consent of ISEL. ISEL expressly disclaims any liability arising out of your use of the Documentation. ISEL reserves the right, at its sole discretion, to change the Documentation without notice at any time. ISEL assumes no obligation to correct any errors contained in the Documentation, or to advise you of any corrections or updates. ISEL expressly disclaims any liability in connection with technical
| support or assistance that may be provided to you in connection with the Information.

THE DOCUMENTATION IS DISCLOSED TO YOU “AS-IS” WITH NO WARRANTY OF ANY KIND. ISEL MAKES NO OTHER WARRANTIES, WHETHER EXPRESS, IMPLIED, OR STATUTORY, REGARDING THE DOCUMENTATION, INCLUDING ANY WARRANTIES OF MERCHANTABILITY, FITNESS FOR A PARTICULAR PURPOSE, OR NONINFRINGEMENT OF THIRD-PARTY RIGHTS. IN NO EVENT WILL ISEL BE LIABLE FOR ANY CONSEQUENTIAL, INDIRECT, EXEMPLARY, SPECIAL, OR INCIDENTAL DAMAGES, INCLUDING ANY LOSS OF DATA OR LOST PROFITS, ARISING FROM YOUR USE OF THE DOCUMENTATION.

| ®2022 ISEL. All rights reserved.

ISEL, the ISEL logo, and other designated brands included herein are trademarks of ISEL. All other trademarks are the property of their respective
| owners.

DE10-LITE EXP. BOARD – REFERENCE MANUAL | AAA.BB.CC.DD: NOME DO REGULAMENTO
2/11 | Rua Conselheiro Emídio Navarro 1 1959-007 Lisboa- Portugal

Overview
This document describes the hardware features of the DE10-Lite Expansion Board, including the detailed pin-out and component reference information required to create custom digital designs based on DE10-Lite Development Board.

DE10-LITE EXPANSION BOARD – REFERENCE MANUAL

Pág. 3/11 | Rua Conselheiro Emídio Navarro 1 1959-007 Lisboa- Portugal

## Contents

DE10-LITE EXPANSION BOARD – REFERENCE MANUAL

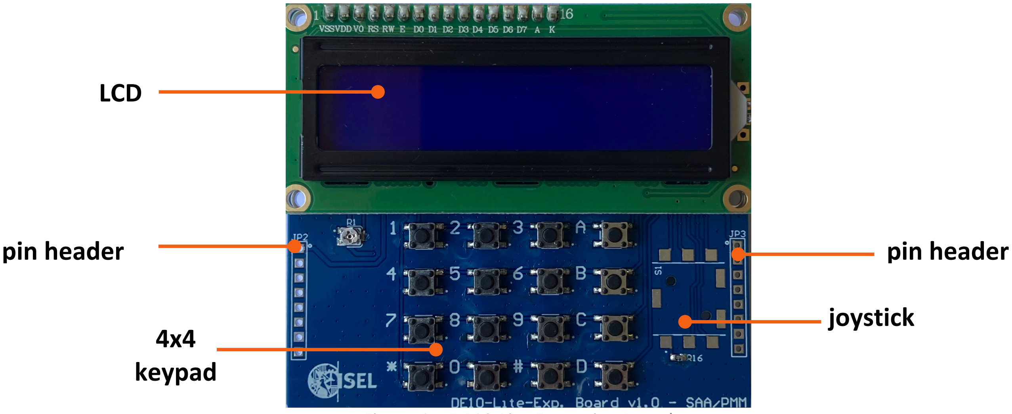
[picture p33: figure]
pin header
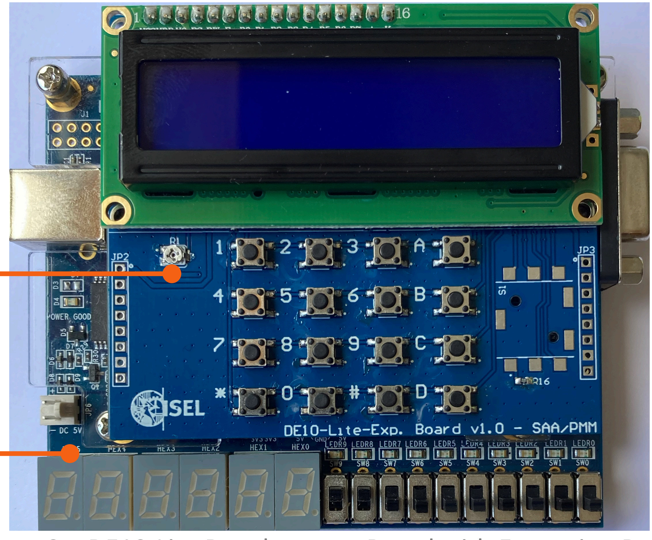
[picture p34: figure]

Pág. 4/11 | Rua Conselheiro Emídio Navarro 1

### 1 INTRODUCTION

The DE10-Lite-Exp. Board is an expansion board for the DE10 lite Development Board that includes a Liquid Crystal Display (LCD), a 4x4 matrix keypad, one placeholder for a joystick (for future expansion) and two placeholders for pin headers (for future expansion).
For more information on the DE10-Lite Development Board, refer to the DE10-Lite User Manual.

### 1.1 Board Layout

Figure 1 – DE10-Lite Expansion Board

### 1.2 DE10-Lite with expansion board

Figure 2 – DE10-Lite Development Board with Expansion Board

LCD

4x4
keypad

joystick

Expansion
Board

DE10-Lite
development
board

DE10-LITE EXPANSION BOARD – REFERENCE MANUAL

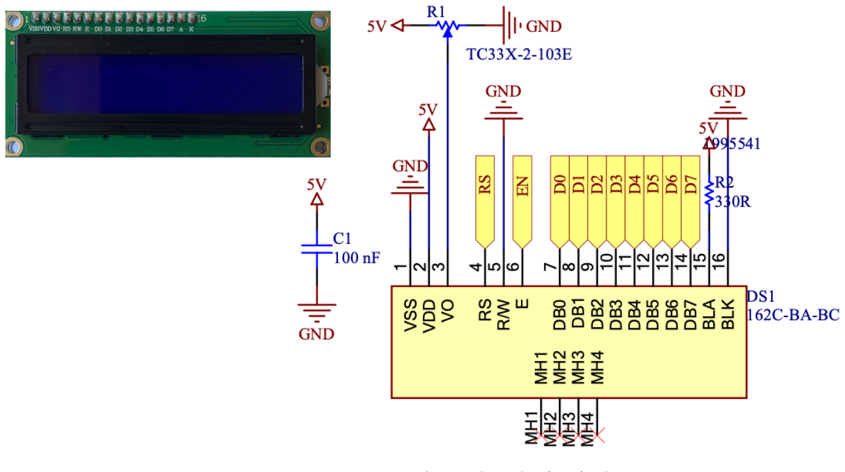
[picture p35: figure]

Pág. 5/11 | Rua Conselheiro Emídio Navarro 1

### 2 USING DE10-LITE EXPANSION BOARD

### 2.1 Liquid Crystal Display (LCD)

The Liquid Crystal Display (LCD) is a two (2) lines and sixteen (16) columns text char matrix, with a four (4) or eight (8) bit interface. In this development board only write operations to the LCD are allowed. The LCD uses a HD44780U Dot Matrix Liquid Crystal Display Controller.
For more information on the HD44780U Dot Matrix Liquid Crystal Display Controller, refer to the HD44780U Datasheet.

Figure 3 - Liquid Crystal Display (LCD) schematic

Table 1 – Pin Assignment of Liquid Crystal Display (LCD)
Signal Name | FPGA Pin No. | Description | I/O Standard
LCD_RS | PIN_W8 | RS | 3.3-V LVTTL
LCD_EN | PIN_V5 | Enable | 3.3-V LVTTL
LCD_DATA[0] | PIN_AA15 | D0 | 3.3-V LVTTL
LCD_DATA[1] | PIN_W13 | D1 | 3.3-V LVTTL
LCD_DATA[2] | PIN_AB13 | D2 | 3.3-V LVTTL
LCD_DATA[3] | PIN_Y11 | D3 | 3.3-V LVTTL
LCD_DATA[4] | PIN_W11 | D4 | 3.3-V LVTTL
LCD_DATA[5] | PIN_AA10 | D5 | 3.3-V LVTTL
LCD_DATA[6] | PIN_Y8 | D6 | 3.3-V LVTTL
LCD_DATA[7] | PIN_Y7 | D7 | 3.3-V LVTTL

DE10-LITE EXPANSION BOARD – REFERENCE MANUAL

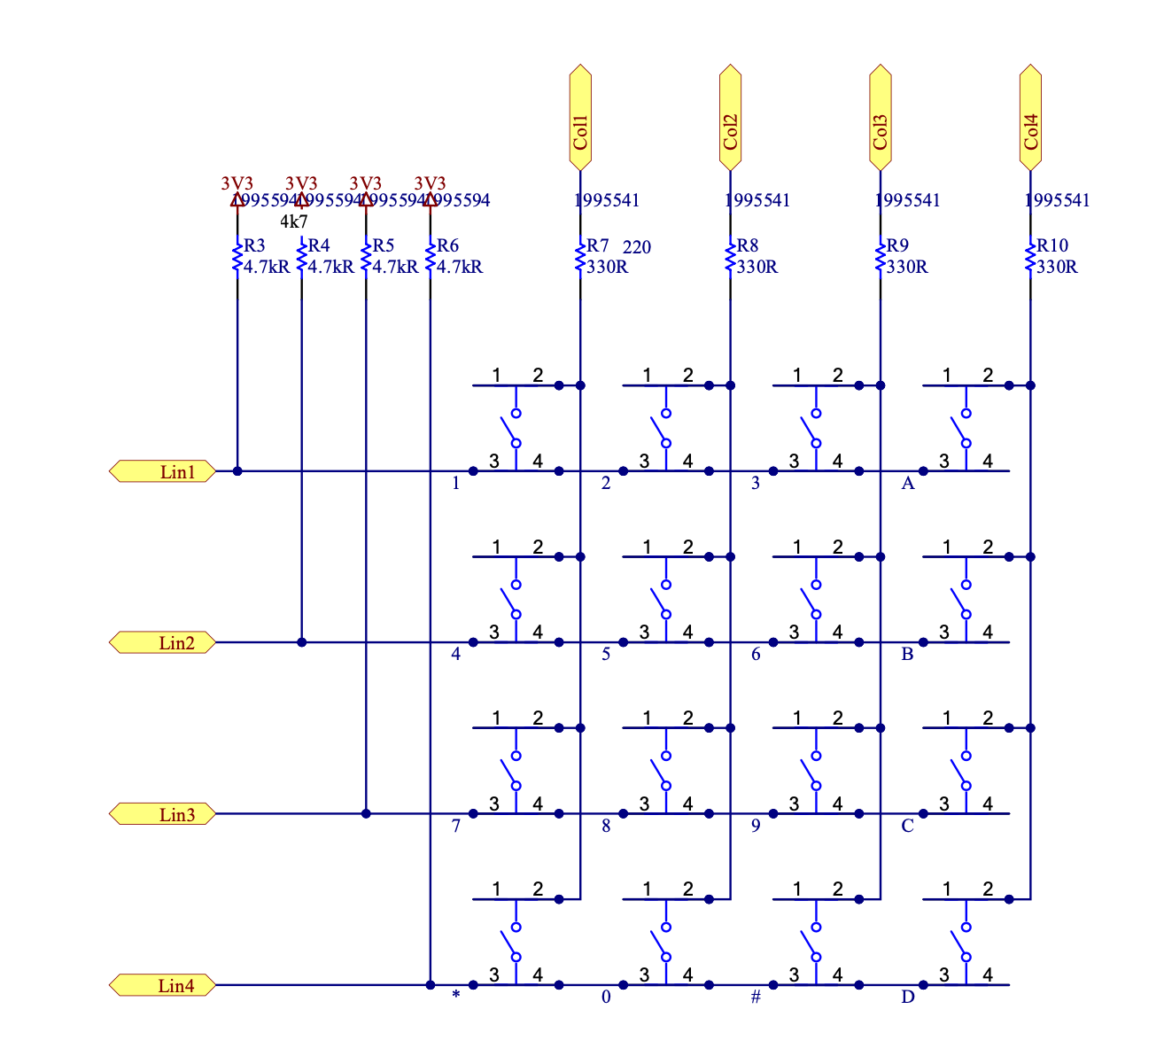
[picture p36: figure]
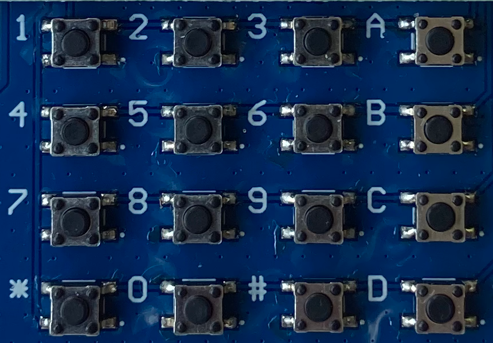
[picture p37: figure]

Pág. 6/11 | Rua Conselheiro Emídio Navarro 1

2.2 4x4 KeyPad
The 4x4 KeyPad is organized in a four by four matrix, the four lines have pull-up resistors, while the columns have protection resistors.

Figure 4 – 4x4 KeyPad schematic

Table 2 – Pin Assignment of 4x4 KeyPad
Signal Name | FPGA Pin No. | Description | I/O Standard
KEYPAD_LIN[0] | PIN_W5 | 4x4 keypad line 1 | 3.3-V LVTTL
KEYPAD_LIN[1] | PIN_AA14 | 4x4 keypad line 2 | 3.3-V LVTTL
KEYPAD_LIN[2] | PIN_W12 | 4x4 keypad line 3 | 3.3-V LVTTL
KEYPAD_LIN[3] | PIN_AB12 | 4x4 keypad line 4 | 3.3-V LVTTL
KEYPAD_COL[0] | PIN_AB11 | 4x4 keypad column 1 | 3.3-V LVTTL
KEYPAD_COL[1] | PIN_AB10 | 4x4 keypad column 2 | 3.3-V LVTTL
KEYPAD_COL[2] | PIN_AA9 | 4x4 keypad column 3 | 3.3-V LVTTL
KEYPAD_COL[3] | PIN_AA8 | 4x4 keypad column 4 | 3.3-V LVTTL

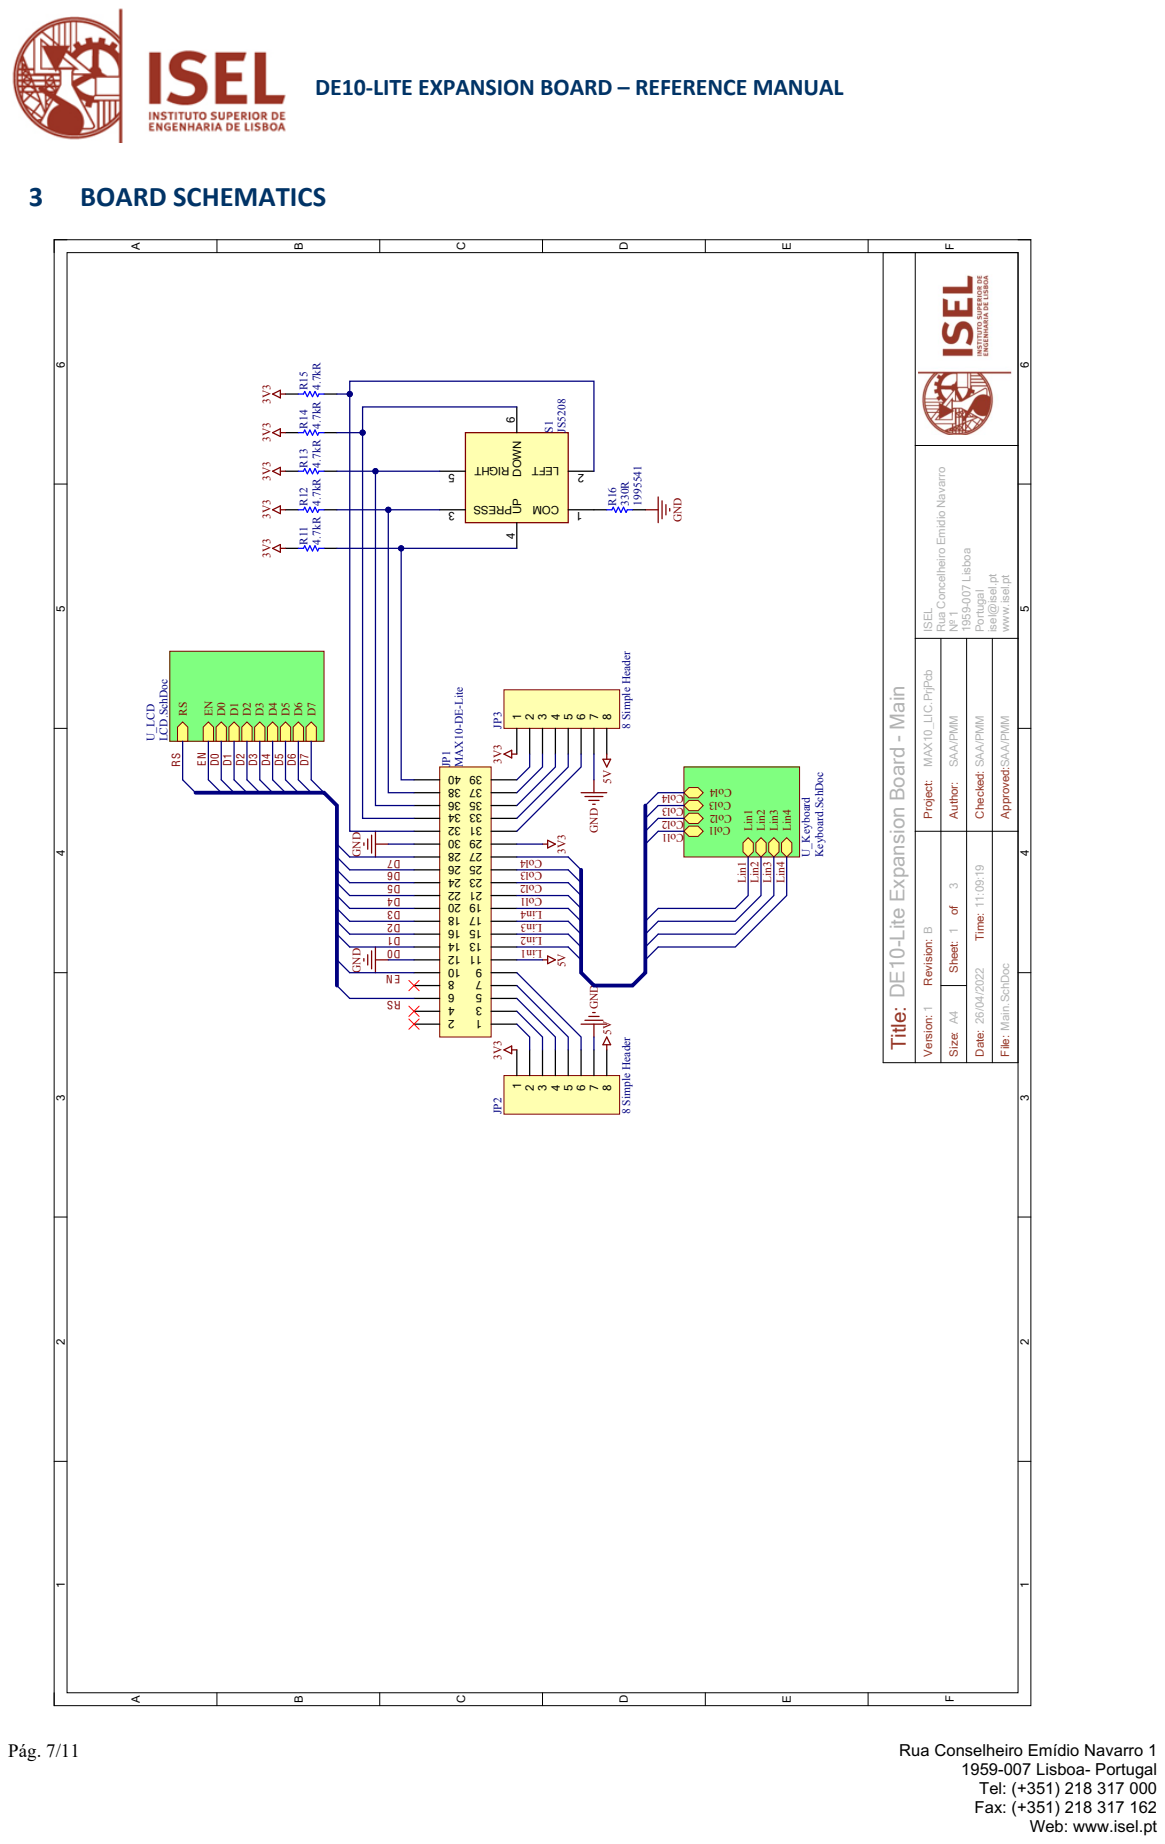
[picture p38: page 8]

DE10-LITE EXPANSION BOARD – REFERENCE MANUAL

Rua Concelheiro Emidio Navarro

www.isel.pt Approved:

DE10-Lite Expansion Board - Main

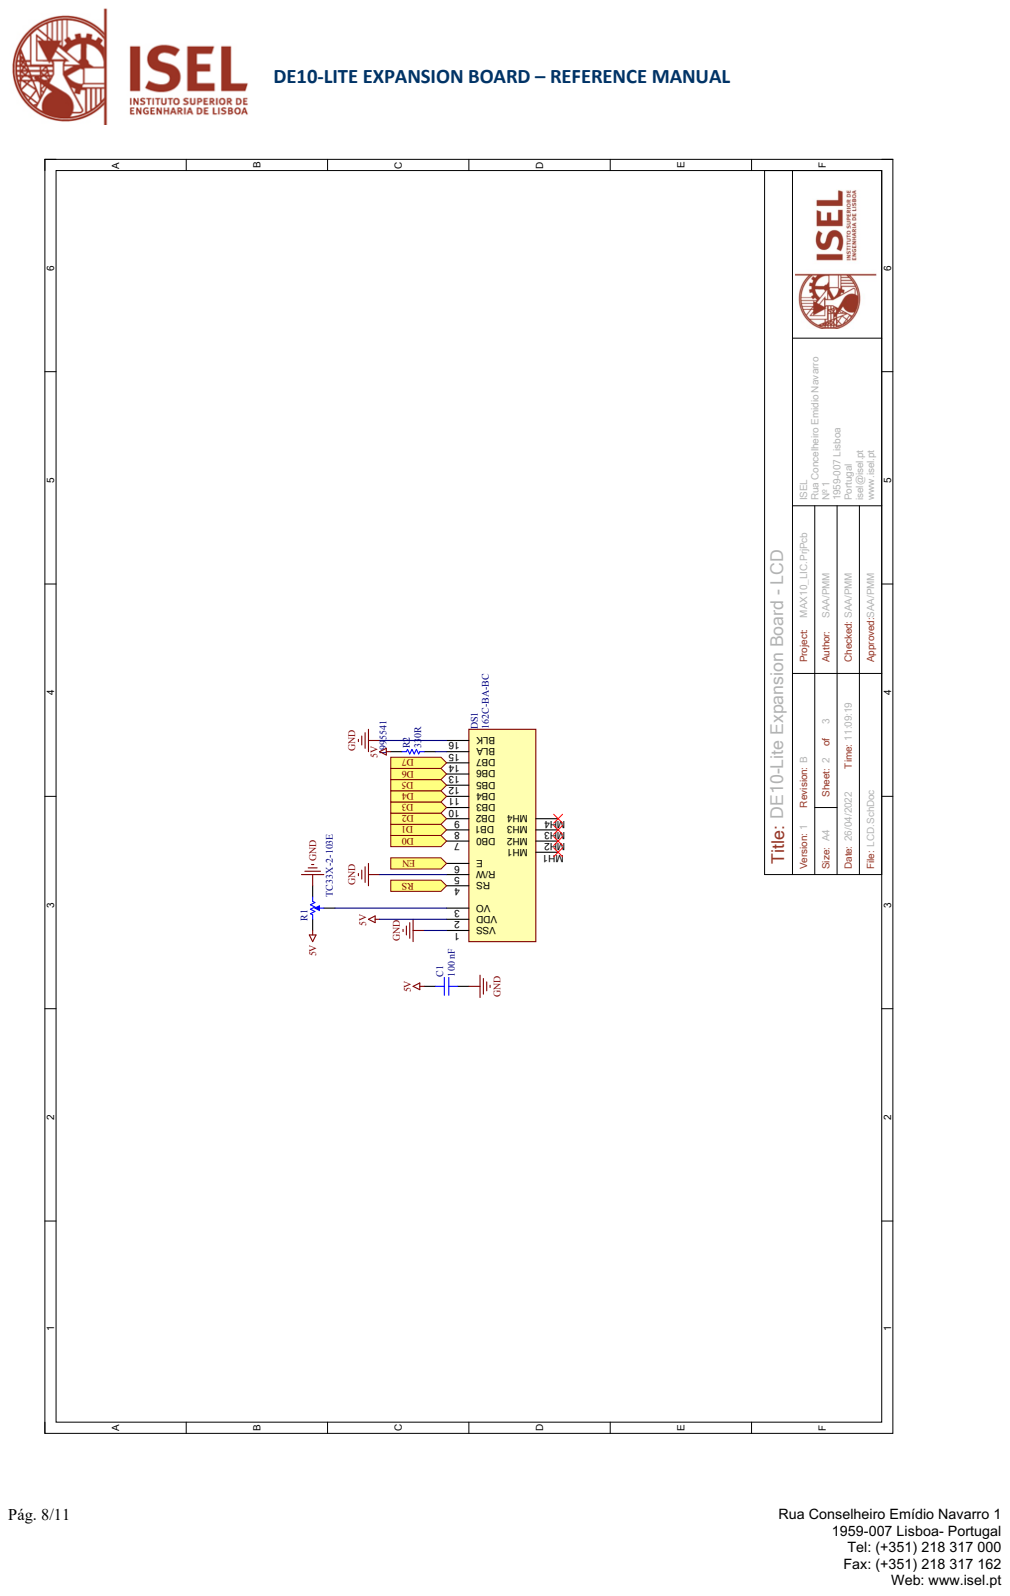
[picture p39: page 9]
Pág. 8/11; Rua Conselheiro Emídio Navarro 1; ISEL; 1959-007 Lisboa; Portugal; LCD.SchDoc; Title:; Size:; Version:; Date:; File:; Revision:; Sheet: of; Time:; Author:; Checked:; SAA/PMM; Project: MAX10_LIC.PrjPcb; GND 5V; GND

DE10-LITE EXPANSION BOARD – REFERENCE MANUAL

Rua Concelheiro Emidio Navarro

isel@isel.pt

www.isel.pt Approved:

DE10-Lite Expansion Board - LCD

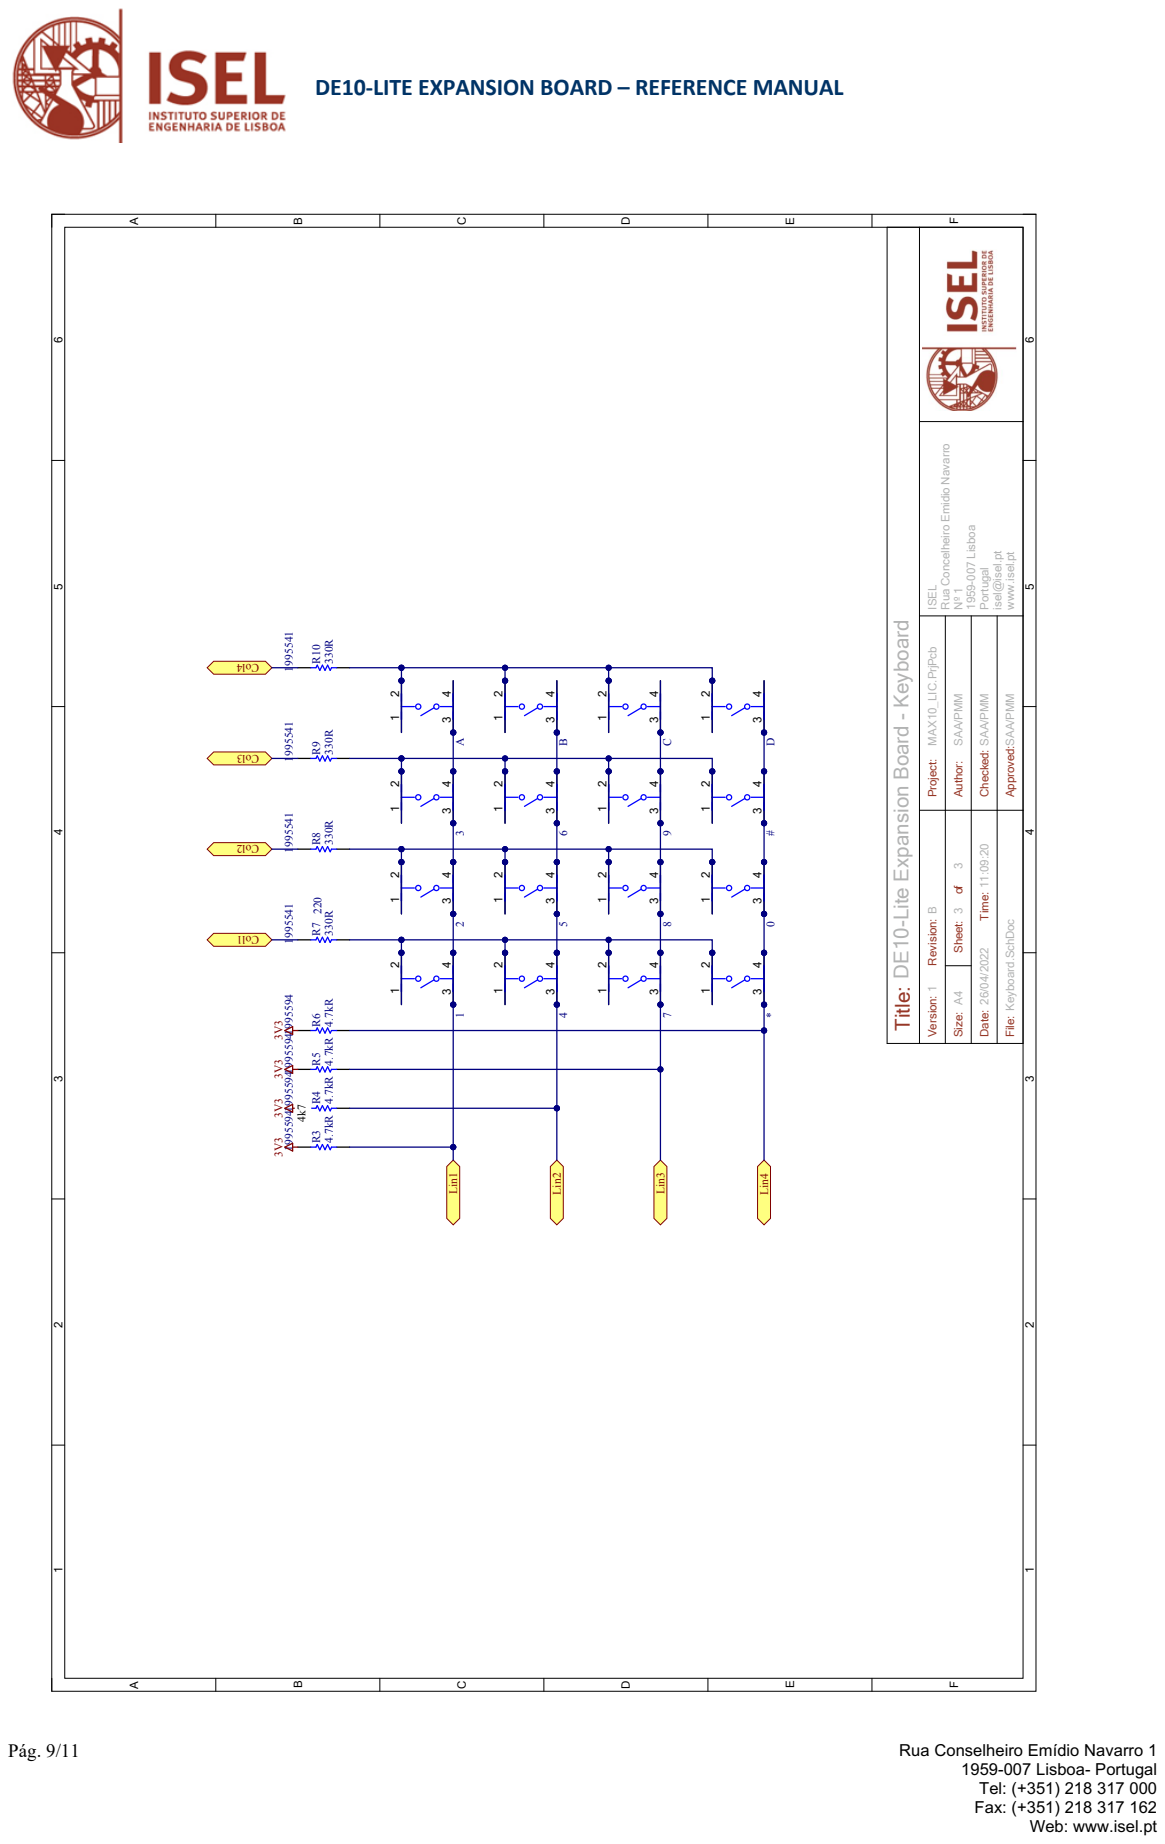
[picture p40: page 10]

DE10-LITE EXPANSION BOARD – REFERENCE MANUAL

Rua Concelheiro Emidio Navarro

www.isel.pt Approved:

DE10-Lite Expansion Board - Keyboard

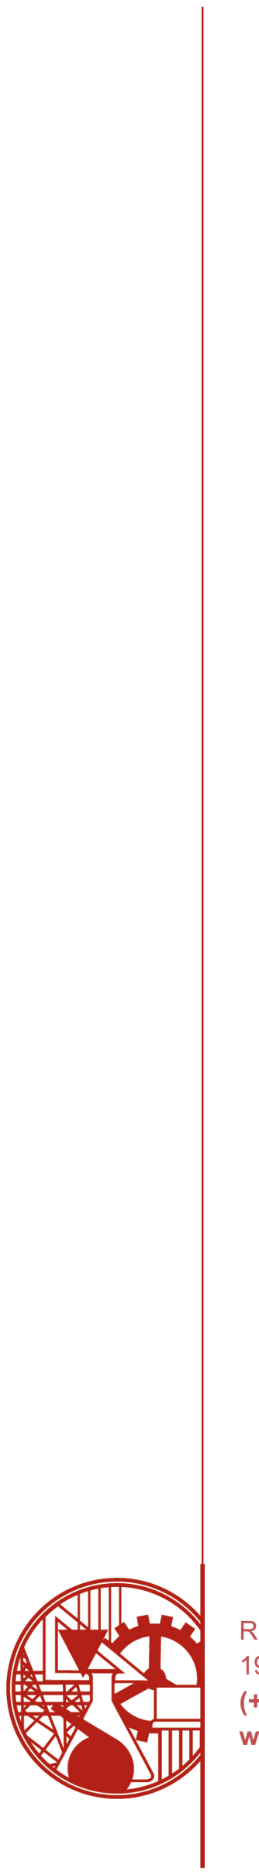
[picture p41: figure]

Rua Conselheiro Emídio Navarro, 1 1959-007 Lisboa PORTUGAL
(+351) 218317000
www.isel.pt
