leonardosilva-leic/ProjetoLIC-ISEL/Manuais/de10-Lite Exp. Board v1.0 - Schematics.pdf

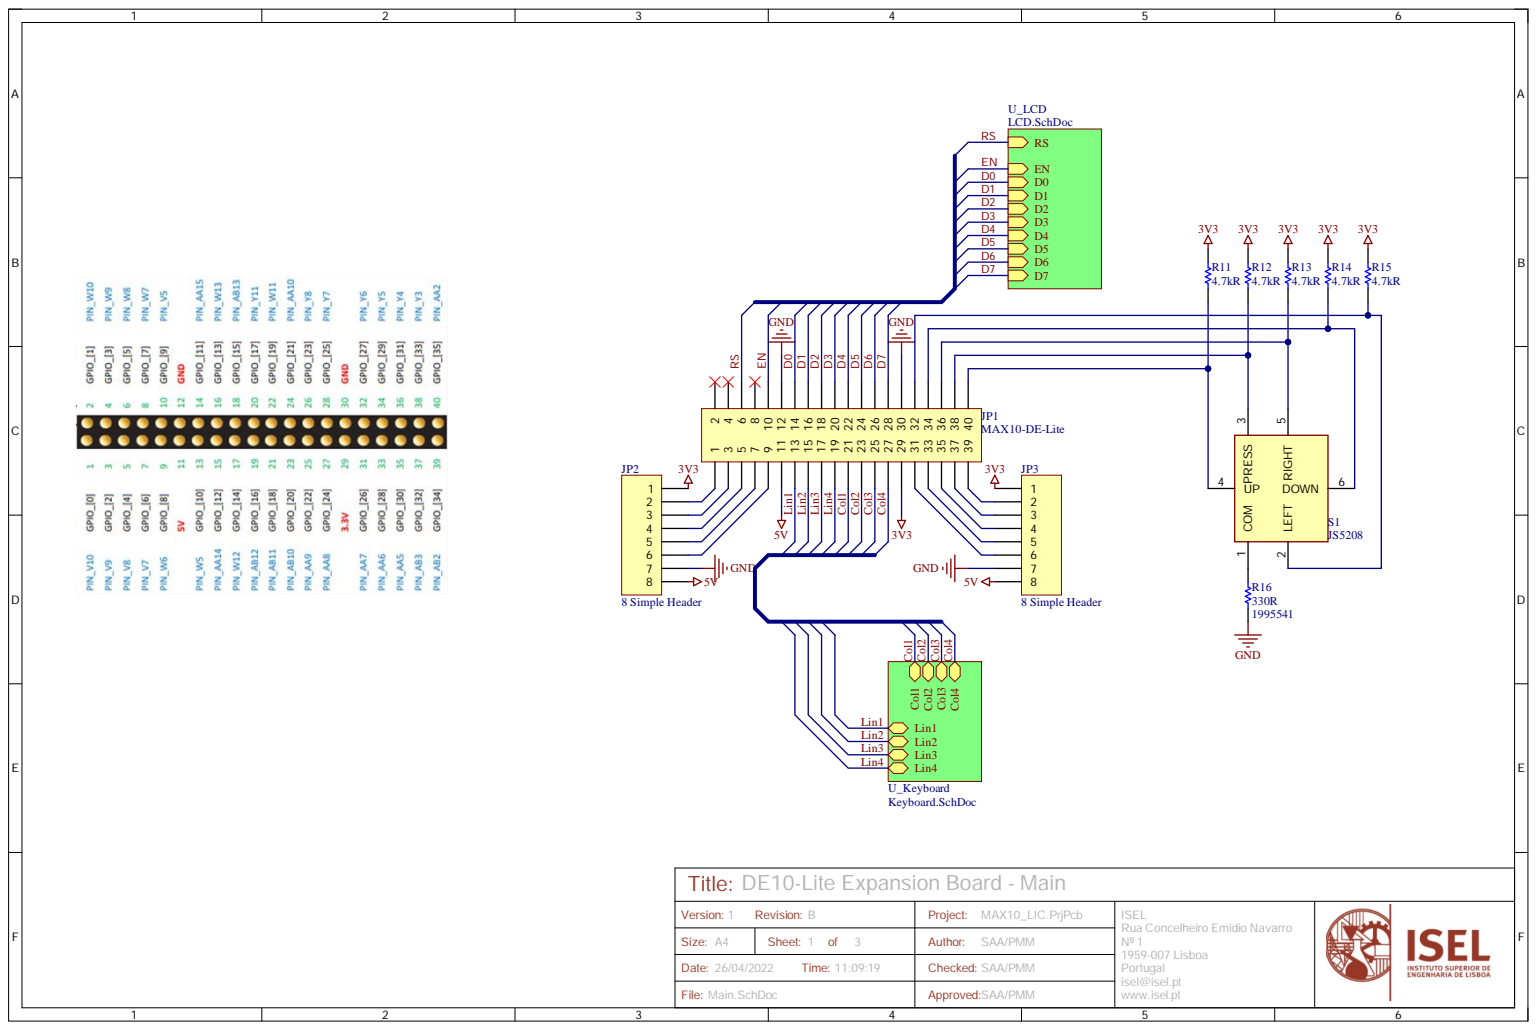
[picture p42: page 1]

PRESS 3 UP 4 RIGHT 5 DOWN 6

DE10-Lite Expansion Board - Main
Title:

Version: 1 Revision: B | Project: MAX10_LIC.PrjPcb | ISEL Rua Concelheiro Emidio Navarro Nº 1 1959-007 Lisboa Portugal isel@isel.pt www.isel.pt

Size: A4 | Sheet: 1 of 3 | Author: SAA/PMM

Date: 26/04/2022 Time: 11:09:19 | | Checked:

File: Main.SchDoc | | Approved: SAA/PMM

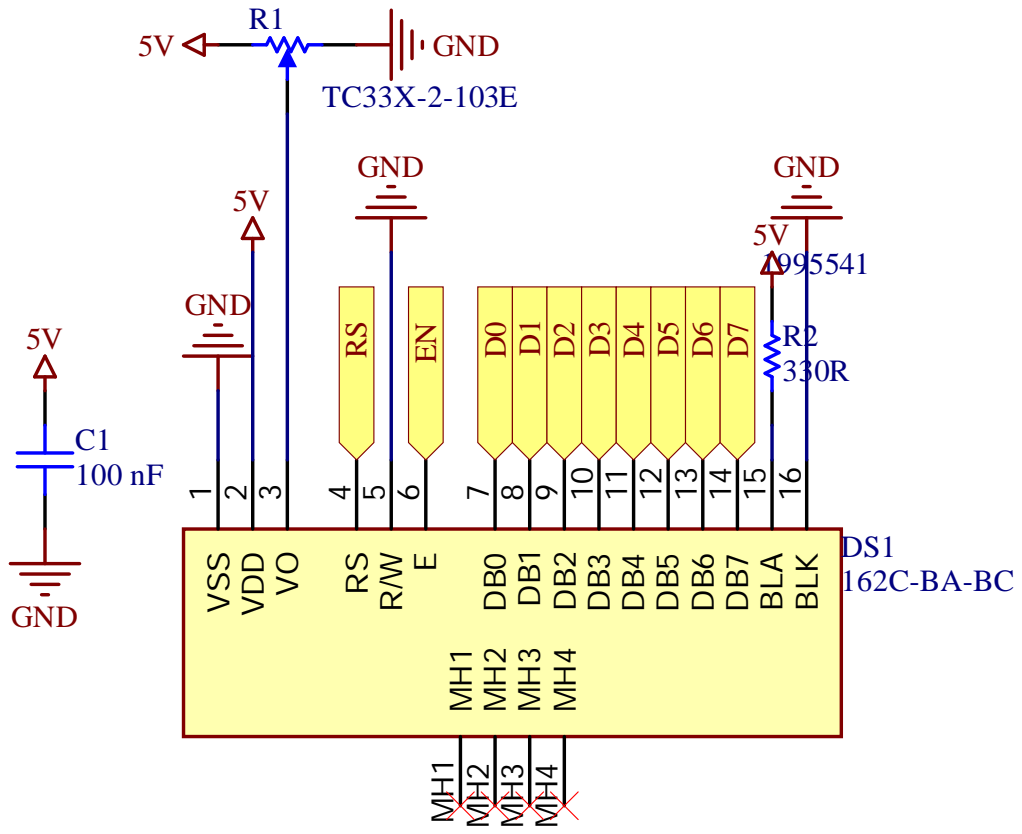
[picture p43: page 2]

DE10-Lite Expansion Board - LCD
Title:

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

Size: A4 | Sheet: 2 of 3 | Author: SAA/PMM

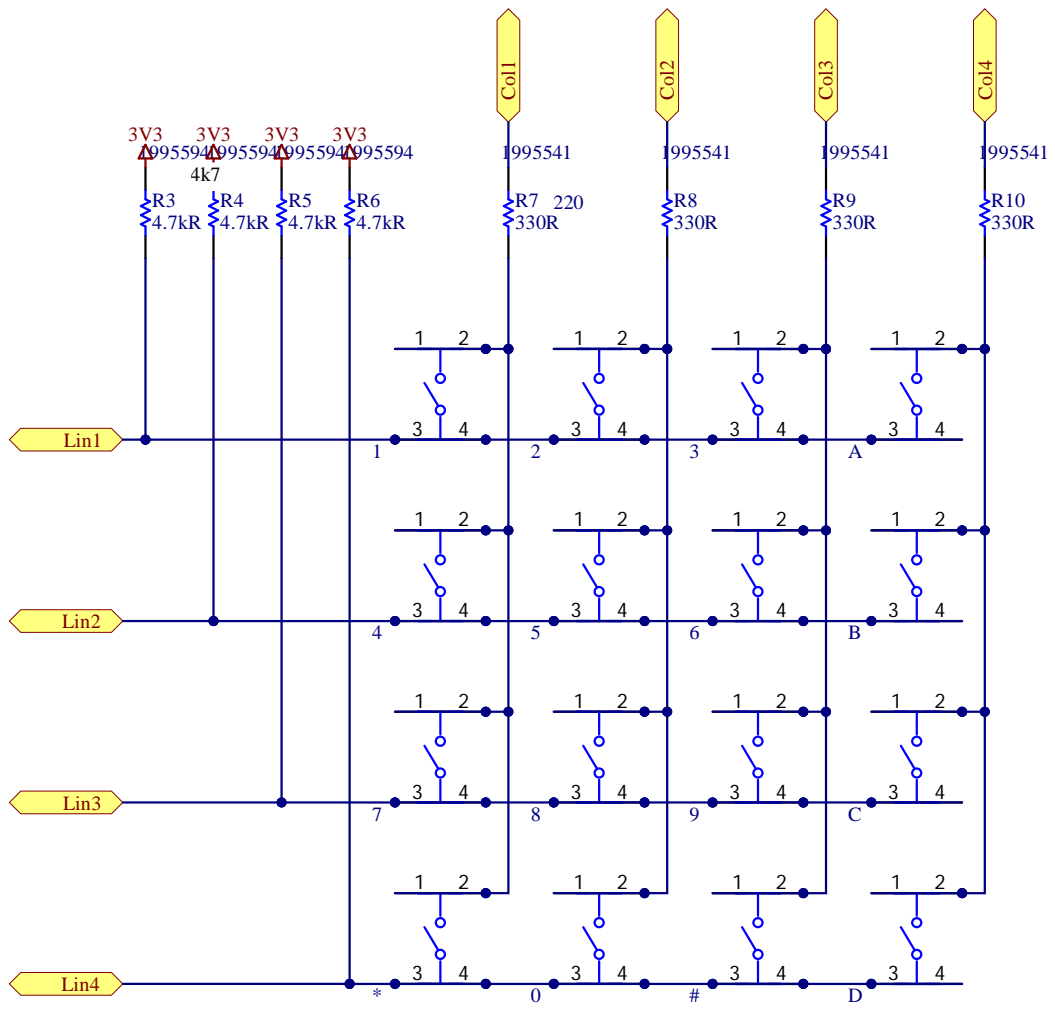
[picture p44: page 3]

DE10-Lite Expansion Board - Keyboard
Title:

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

Size: A4 | Sheet: 3 of 3 | Author: SAA/PMM

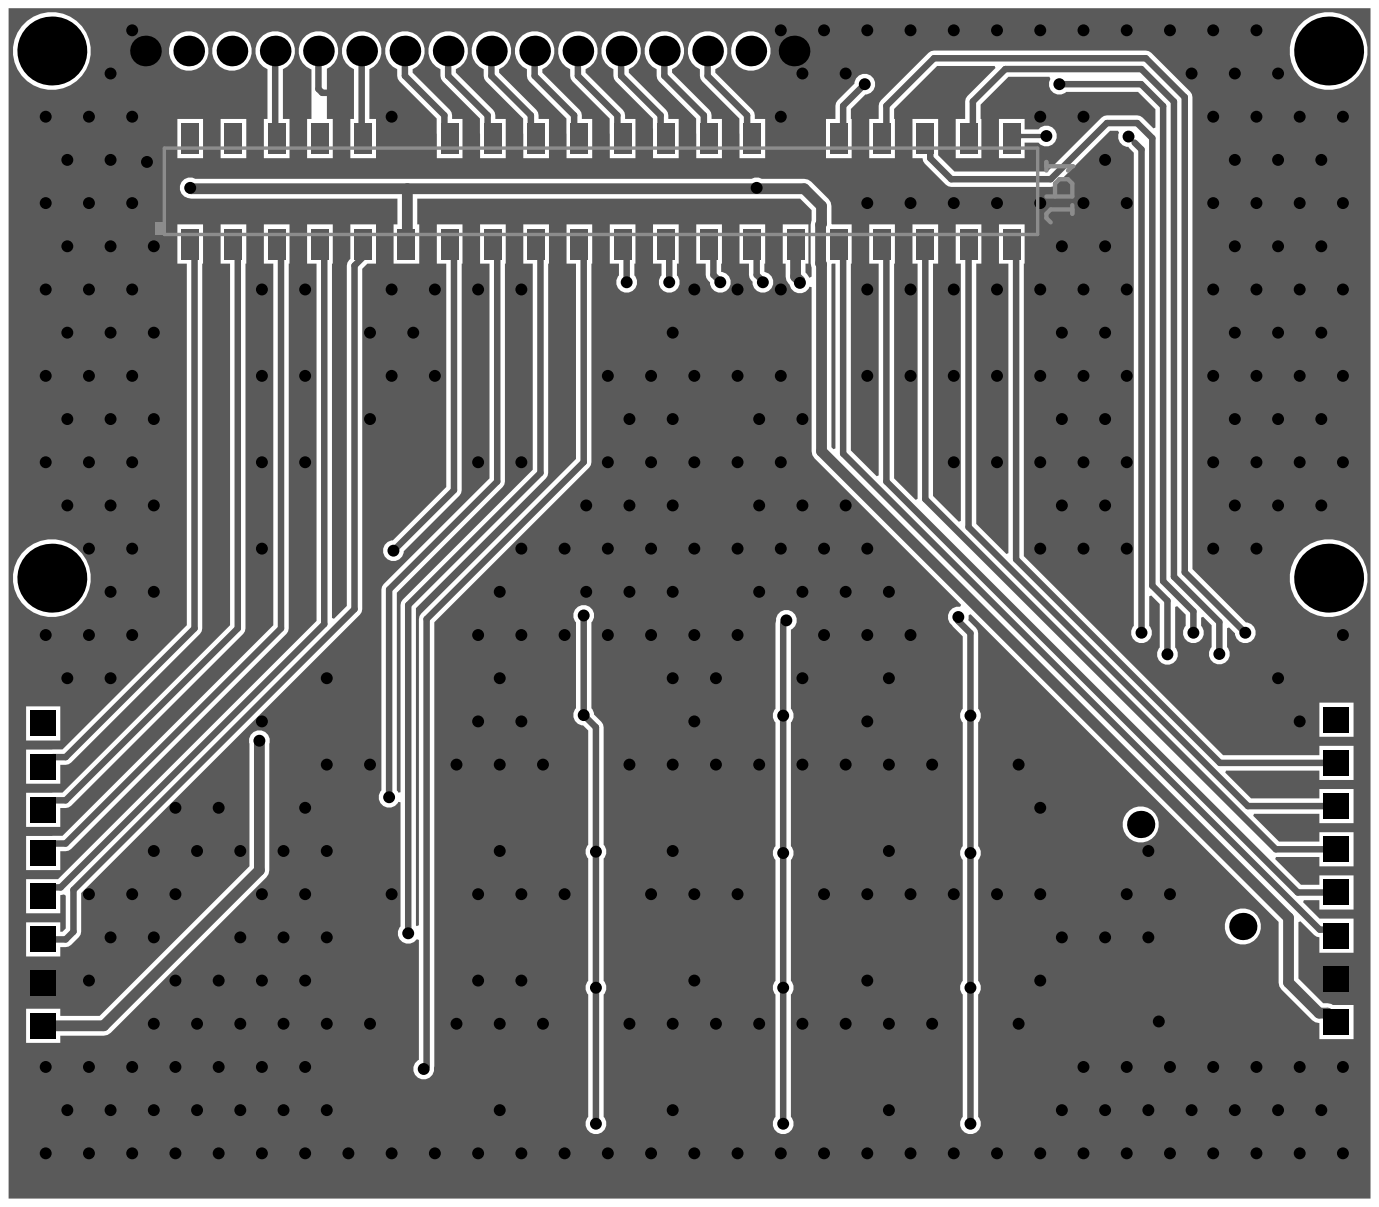
[picture p45: page 4]

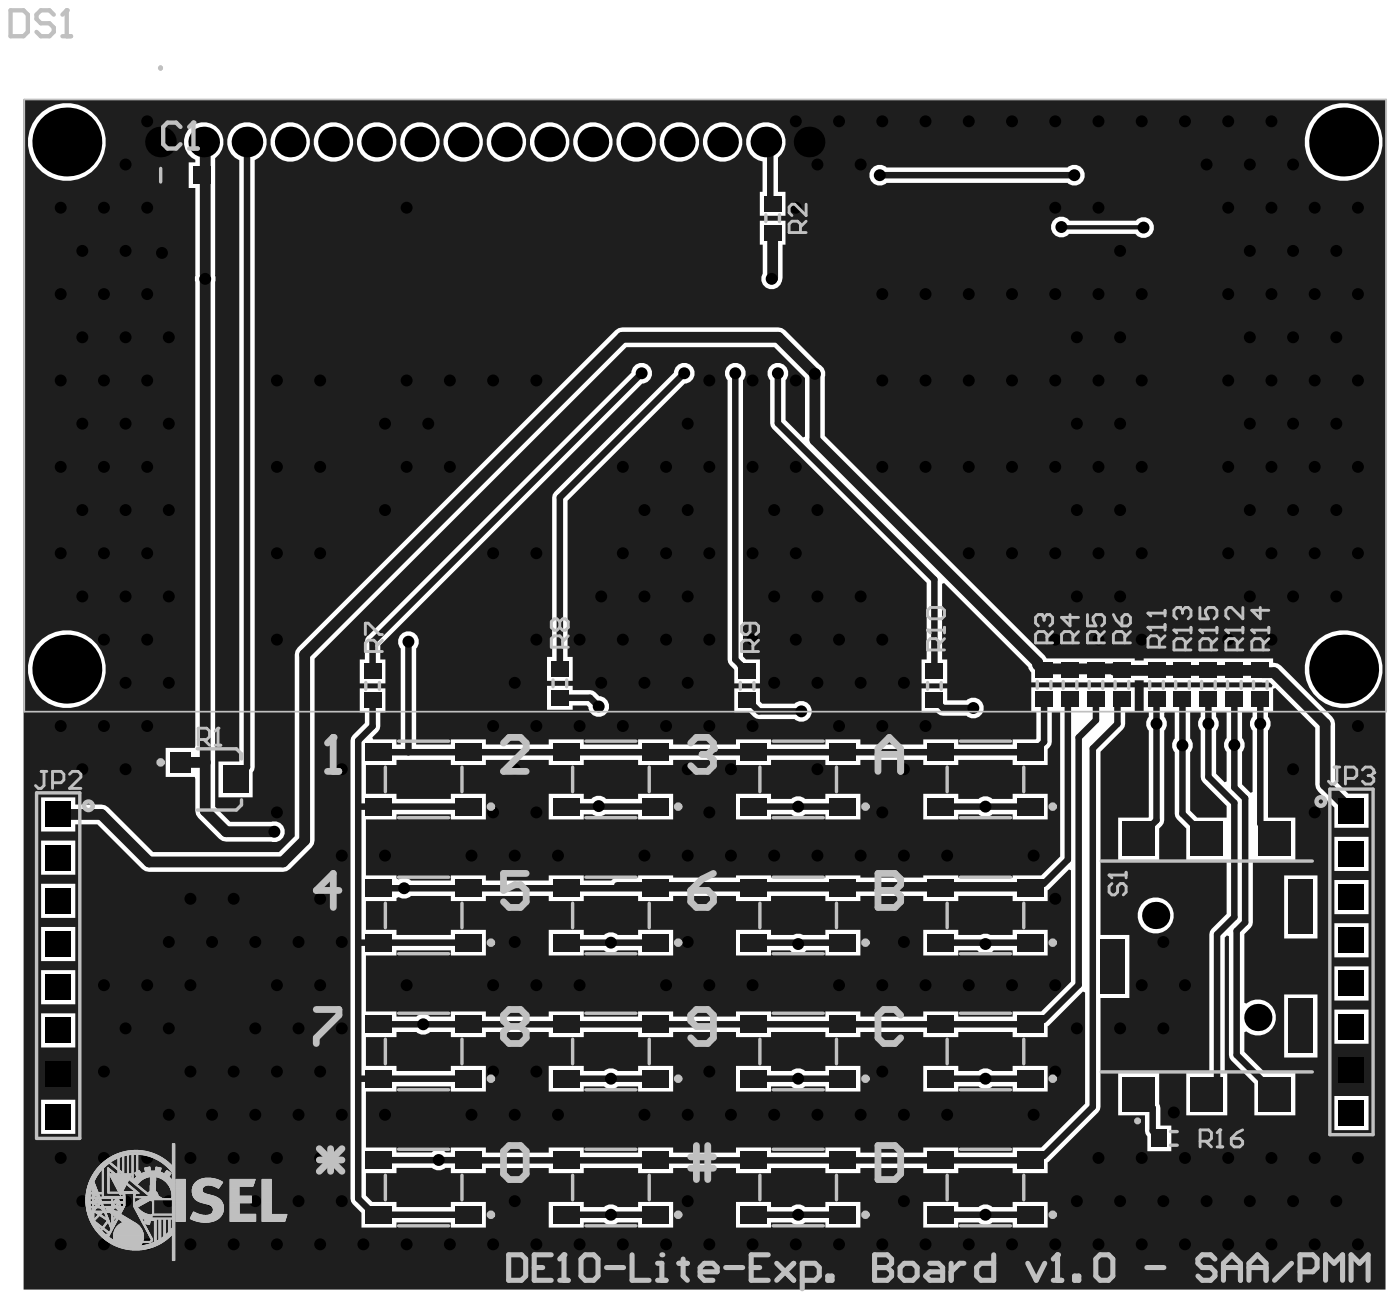
[picture p46: page 5]
